Rodolfo-Pellizzoni-Lab/he-soc/hardware/ip_list/spu/README.md

# SPU — AXI4 / ACE Event Snooper

The **SPU** is a non-intrusive snooper that sits transparently on an AXI4 (or ACE) link —
between a manager and a subordinate — and forwards **event packets** describing the traffic
it observes to the **APMU**. It is how interconnect- and memory-side events (e.g. LLC and
main-memory read/write requests, and per-access latency) enter the centralized monitor. It
is one of the three IPs of the performance-monitoring architecture in our EMSOFT 2026 paper,
alongside the APMU and the per-core EVUs.

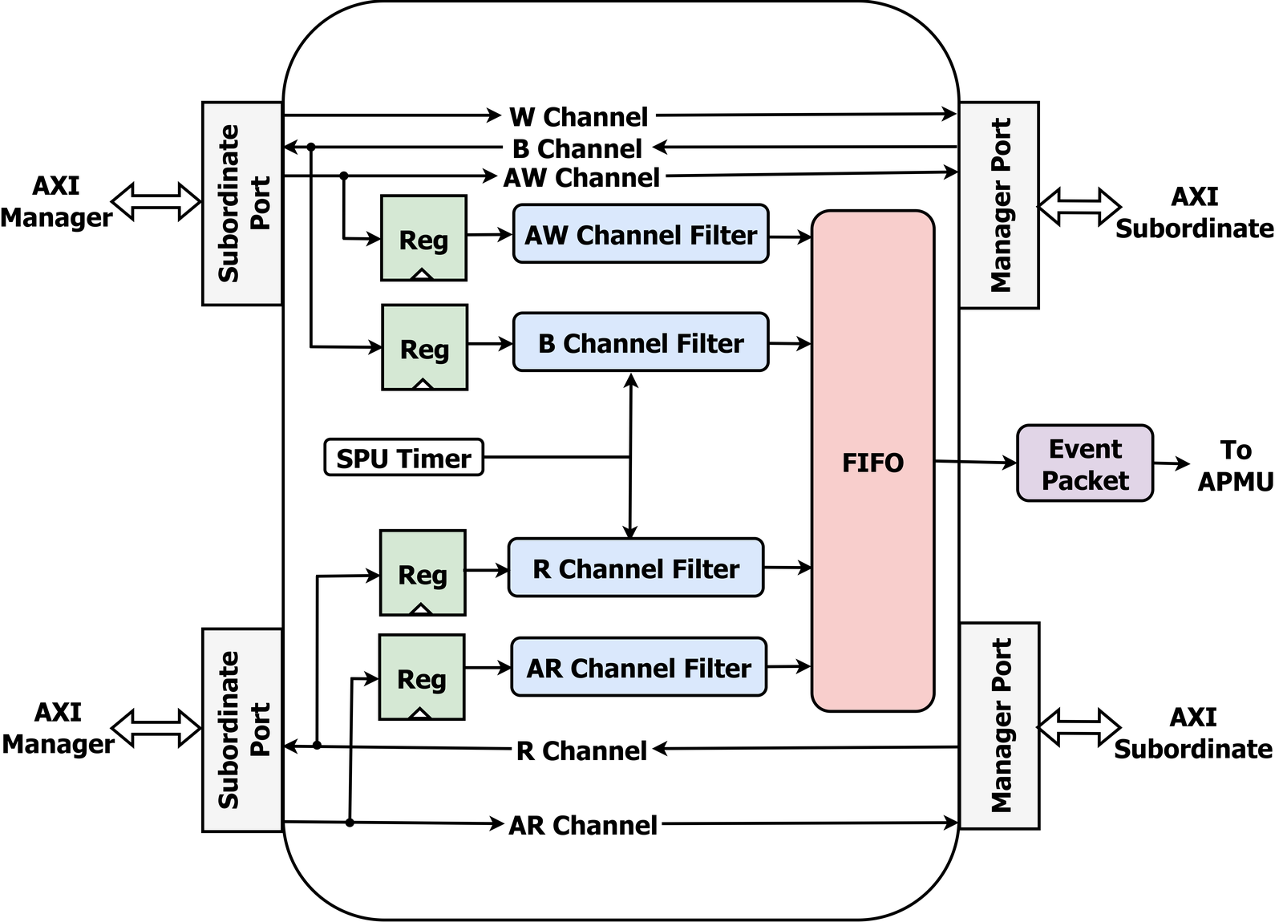
[picture p3: hardware/ip_list/spu/spu_block_diagram.png]
SPU block diagram


## How it works

- The five AXI channels pass **transparently** from the subordinate-side port (`Sb Port`,
  facing the managers) to the manager-side port (`Mn Port`, facing the subordinate) — the SPU
  never alters or delays the traffic it monitors.
- It tracks **read** transactions through the address-read (**AR**) and read-data (**R**)
  channels, and **write** transactions through the address-write (**AW**) and write-response
  (**B**) channels; the write-data (**W**) channel is not monitored. Each monitored channel is
  **sampled** (the `Reg` stage) and passed through a filter that decides which transactions
  produce events and extracts their fields (an event ID plus metadata such as transaction
  size, alignment, or response latency).
- An **SPU timer** timestamps requests and responses, so latency is measured as the time
  between a request and its corresponding response completion.
- Each event type is handled by a dedicated pipeline, and the resulting **event packets are
  stored in a FIFO** that forms the SPU's output interface to the APMU.
- Every event carries a **source**, which the APMU's per-counter source filter matches. By
  default it is a slice of the request's AXI ID (`SourceIDStart`..`SourceIDEnd`). In
  `axi_spu_top`, `ExtSource = 1` makes it the `ar_src_i` / `aw_src_i` input instead, sampled
  with the request, so the instance can derive it from the ID, the user field or both. In both
  variants a response event (R, B) reports the source of the request it answers, kept per
  outstanding request next to its start time. AlSaqr's SPUs on the LLC memory port and on
  the accelerator socket's DMA use `ExtSource` (see "In AlSaqr"); the APMU README lists the
  source codes. The memory-port SPU sits between the LLC and the slowdown regulator, so its
  response latencies include the slowdown's and the DRAM timing model's delays
  (`hardware/host/host_domain.sv`).
- A write response is counted once, also when it is held valid for several cycles (both
  variants; before 2026-10-25 a stalled B counted once per cycle).

## Variants

- `axi_spu_top.sv` — AXI4 snooper.
- `ace_spu_top.sv` — ACE snooper. **On this branch the master/slave ports are wired as
  `ACE_BUS`** (rather than `AXI_BUS`) so the SPU can observe coherent traffic.

## Source layout (`src/`)

| File | Role |
|---|---|
| `axi_spu_top.sv`, `ace_spu_top.sv` | Top-level snooper (AXI4 / ACE). |
| `spu_ax_chan.sv` | Address-channel (AR / AW) event extraction. |
| `spu_r_chan.sv` | Read-transaction tracking: matches an AR request to its R response (read latency). |
| `spu_w_chan.sv` | Write-transaction tracking: matches an AW request to its B response (write latency). |
| `spu_arbiter.sv` | Round-robin merge of the per-pipeline events into the output FIFO. |
| `spu_pkg.sv` | Package: types and parameters. |

Depends on the PULP `axi`, `ace`, and `apmu` packages (see [`Bender.yml`](./Bender.yml));
reusable AXI `typedef`/`assign` macros are in [`include/axi/`](./include/axi).

## In AlSaqr

With *N* cores (APMU ports in brackets for four cores, then for eight; the port map is `ariane_soc::Apmu*Idx`, the
APMU README has the event selects):

| Instance | Where | APMU port | Source | `CAM_DEPTH` |
|---|---|---|---|---|
| `i_spu_core_llc` (`ace_spu_top`), one per core | `hardware/host/cva6_synth_wrap.sv`, between core *c* and its port of the coherence unit | *N*+1+*c* (5-8; 9-16) | bit 0 of the core's AXI ID: it does not tell masters apart, the port is the core | 17 |
| `i_spu_llc_mem` (`axi_spu_top`) | `hardware/host/host_domain.sv`, between the LLC's memory port and the slowdown regulator | 2*N*+1 (9; 17) | `ExtSource`: `ariane_axi_soc::mem_src`, the master the request came from | 17 |
| `i_spu_accel` (`axi_spu_top`) | `hardware/host/cva6_subsystem.sv`, on the accelerator socket's DMA master in front of its port of the coherence unit | 2*N*+2 (10; 18) | `ExtSource`: the constant `ariane_soc::CcuAccelPort` (*N*: 4; 8), the code `i_spu_llc_mem` gives the socket's requests | 8 |

All of them count DRAM addresses only (rule 1 of the same 2-rule map, `[HYAXIBase, HYAXIBase + HYAXILength)`) and run
on the SoC clock. The cores' SPUs reach the APMU through a 4-entry CDC FIFO each, the other two directly. The socket's
SPU sees the accelerators' DMA before the coherence unit and the LLC (hits and misses alike) and nothing else, not the
Ethernet DMA, which has a port of its own. Each CAM holds one entry per outstanding request of its direction, inserted
whatever the address, so `CAM_DEPTH` must be at least the master's reads (writes) in flight: a request that finds the
CAM full still counts, but a response of its ID then goes uncounted. The socket has at most 4 requests in flight, reads
and writes together, all with ID 0.

An SPU's source (`SourceIDEnd - SourceIDStart + 1` bits) is zero-extended into the APMU's source field,
`pmu_pkg::SOURCE_ID_BITS` bits, which follows the core count like the APMU's port field: 4 bits with up to four cores,
5 with more (the `NUM_CVA6` define; the APMU README has both Event Sel layouts). The cores' SPUs have a 1-bit source,
the other two `ariane_soc::MemSrcWidth` bits, which is `SOURCE_ID_BITS`; `axi_spu_top` reports a wider source in
simulation.

## Simulation

```
bender update
cd scripts
./compile_vsim.sh
./run_vsim.sh
python3 post_sim_script.py <TbMasters> <TbNumReads> <TbNumWrites>
```

Testbench sources are in [`test/`](./test) (`tb_spu.sv`, `spu_test.sv`). The instances in
the full SoC are listed in "In AlSaqr" above.

`tb_spu.sv` is stale: it instantiates `spu_top`, which `src/` does not have (the tops are `axi_spu_top` and
`ace_spu_top`), so it does not elaborate. `hardware/xsim/tests/run_spu_b.sh` (testbench `tb_spu_b.sv` next to it,
no SoC build needed) is a directed xsim test of the 2026-10-25 held-B fix in `axi_spu_top`: one write-response event
per write, with its own latency and source, also while a second write of the same ID is outstanding.
`SPU_TOP_SV=<file>` runs it on another `axi_spu_top.sv`; one with the old `new_b_resp_q <= new_b_resp_q;` put back
must fail.

`software/soc_tests/t_spulat` checks the latencies in the SoC: core 0's line reads and write-backs outside the LLC
window on the memory port's SPU (APMU port 2*N*+1), each counted exactly, with their latency sums and the smallest and
largest latency (Event Info `ADD_RESP_LAT` and its `KEEP_MIN` / `KEEP_MAX` opcodes), and one DMA copy of the
accelerator socket on its SPU (port 2*N*+2) against port 2*N*+1's source *N*. In xsim, with 4 and with 8 cores: reads
38 cycles on average (31-46), write-backs 42 (36-49); the socket's reads and writes take 32 cycles more at port
2*N*+2 than at port 2*N*+1 (66 against 34, 69 against 37).

## License

Released under the **Solderpad Hardware License v0.51** (treatable, at the licensee's
option, as Apache-2.0). See [`LICENSE`](./LICENSE).
