Rodolfo-Pellizzoni-Lab/he-soc/hardware/ip_list/can_bus/doc/pics/Untitled 1.bmp

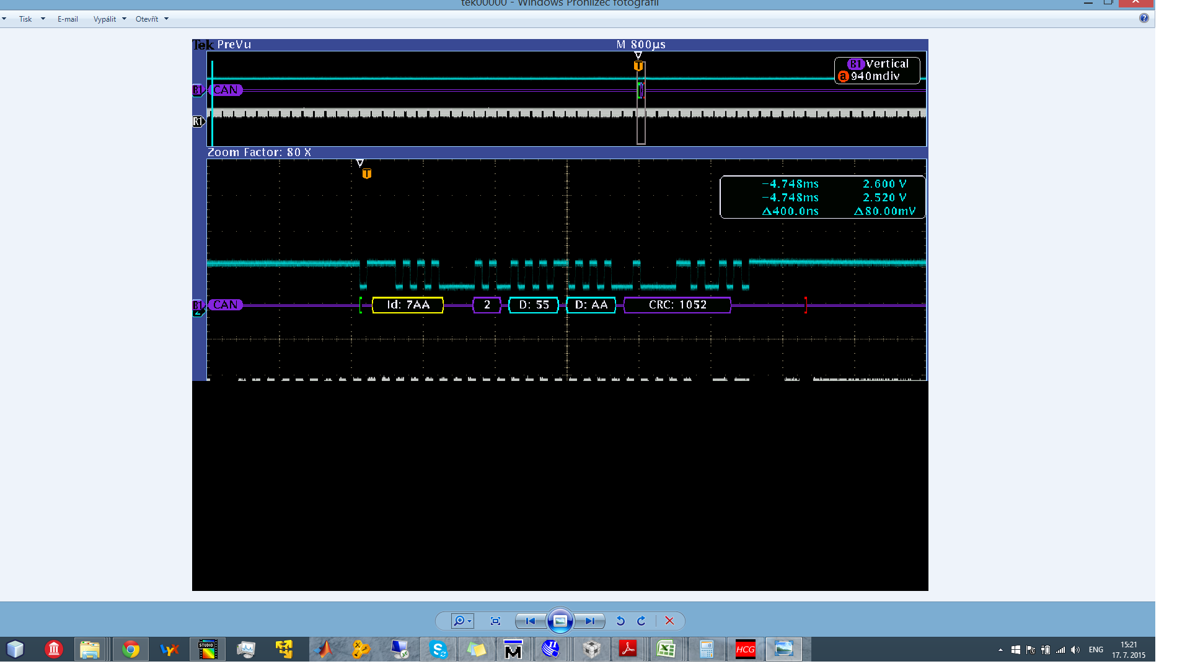
hardware/ip_list/can_bus/doc/pics/Untitled 1.bmp
