Rodolfo-Pellizzoni-Lab/he-soc/hardware/ip_list/udma_i2c/docs/I2C_reference.xlsx

Sheet: Info
Document Information
Name | I2C reference
Category | IP reference
Author | Florent Rotenberg
Version | 1.0
Status | Fisrt Release
Description | I2C interface definition
IP Information
IP type | I2C
Delivery Type
History
Date | Modification | Author
26/10/2016 | 1strelease | F.Rotenberg
Content
Info | This sheet. General information about document usage
Usage | Guidelines on how to used the various sheet
IP Release | Release information sheet describing
IPIF_relx.x | IP interface description reference, describing IP symbol/entity and integration and test information relative to IP interface.
IPDESCR_Relx.x | Description of the main features of the IP
IPREGLIST_rely.y | Description of the list of registers used by IP. Registers can be physically instanciated inside IP or outside IP.
IPREGMAP_relz.z | Description of mapping of bit fields when registers are internal to IP. This sheet is optional for IP which are not instanciating registers as information can be build from IPIF and IPRELIST sheet.
IPTREGMAP_relz.z | Description of mapping of test bit field when registers are internal to IP. This sheet is optional for IP which are not instanciating registers as information can be build from IPIF and IPRELIST sheet.
IPUDMACMDLIST_relz.z | Description of IP UDMA commands list used by IP.

Sheet: Usage
IP Release Sheet
 | Column | Description | Possible Value
 | Version | IP release version numeroted as [major release].[minor release]. A release is major whenever IP interface is modified. | X.Y. Z
 | Release description | This is a free text entry expliciting the release main modifications and purpose. | Text
 | IPIF | IPIF sheet version to be used for this release. | X.Y. Z
 | IPDESCR | IPDESCR sheet version to nbe used for this release | X.Y.Z
 | IPREGLIST | IPREGLIST sheet version to be used for this release. | X.Y. Z
 | IPREGMAP | IPREGMAP sheet version to be used for this release. | X.Y. Z
 | IPUDMACMDLIST | IPUDMACMDLIST sheet version to be used for this release. | X.Y. Z
 | IPDOC | IPDOC version to be used for this release. | X.Y. Z
 | GIT version | GIT database number corresponding to IP design code and IP reference XLS. | Integer
IPIF sheet
IP Interface description | IP Pin Name | Name of IP Pin. This must must exactly name find in code or schematic (including case).
 | Direction | Direction or type of signal | In,Out,IO
 | Type | Analog, Digital, supply, DR (Dual Rail), SR (SingleRail) | Analog,Digital, VDD, GND, DR, SR
 | Voltage Domain
 | Clock domain
 | IO
 | Size
 | Reset Value
 | Description
Integration information | Integration comment
 | Core Interface
 | Register Interface
 | Register name
 | DFT value
 | Level Shifter
 | Isolation cell
 | Connected to
 | Load
 | Drive
 | Destination supply
Hard Macro information | location
 | layer
 | Antenna
Additonal Information | FreeText 1
 | FreeText 2
Driver information | Function1
 | Function2

Sheet: IP Release
Version | Release description | IPIF | IPDESCR | IPREGLIST | IPREGMAP | IPUDMACMDLIST | IPDOC | GIT version
1.0.0 |  | Rel1.0.0 | Rel1.0.0 | Rel1.0.0 | Rel1.0.0 | Rel1.0.0

Sheet: IPIF_rel1.0.0
IP Interface description |  |  |  |  |  |  |  |  | Integration information |  |  |  |  |  |  |  |  |  |  |  |  | Hard Macro information |  |  | Additonal Information |  | Driver information
IP Pin Name | Direction | Type | Voltage Domain | Clock domain | IO | Size | Reset Value | Description | Integration comment | Core Interface | Register Interface | Register name | Bit position | Trim during production | DFT value | Level Shifter | Isolation cell | Connected to | Load | Drive | Destination supply | location | layer | Antenna | FreeText 1 | FreeText 2 | Function1 | Function2
clk_i | IN | digital
rstn_i | IN | digital
ext_events_i | IN | digital
cfg_data_i | IN | digital
cfg_addr_i | IN | digital
cfg_valid_i | IN | digital
cfg_rwn_i | IN | digital
cfg_data_o | OUT | digital
cfg_ready_o | OUT | digital
cfg_rx_startaddr_o | OUT | digital
cfg_rx_size_o | OUT | digital
cfg_rx_continuous_o | OUT | digital
cfg_rx_en_o | OUT | digital
cfg_rx_clr_o | OUT | digital
cfg_rx_en_i | IN | digital
cfg_rx_pending_i | IN | digital
cfg_rx_curr_addr_i | IN | digital
cfg_rx_bytes_left_i | IN | digital
cfg_tx_startaddr_o | OUT | digital
cfg_tx_size_o | OUT | digital
cfg_tx_continuous_o | OUT | digital
cfg_tx_en_o | OUT | digital
cfg_tx_clr_o | OUT | digital
cfg_tx_en_i | IN | digital
cfg_tx_pending_i | IN | digital
cfg_tx_curr_addr_i | IN | digital
cfg_tx_bytes_left_i | IN | digital
data_rx_datasize_o | OUT | digital
data_rx_data_o | OUT | digital
data_rx_valid_o | OUT | digital
data_rx_ready_i | IN | digital
data_tx_datasize_o | OUT | digital
data_tx_data_i | IN | digital
data_tx_valid_i | IN | digital
data_tx_ready_o | OUT | digital
err_o | OUT | digital
scl_i | IN | digital
scl_o | OUT | digital
scl_oe | OUT | digital
sda_i | IN | digital
sda_o | OUT | digital
sda_oe | OUT | digital

Sheet: IPDESCR_rel1.0.0
Description
I2C component manages the following features: - Controls all I2C bus specific sequencing, protocol, arbitration and timing. - Configurable I2C clock frequency related to SoC clock frequency. - Status flags for busy bus and arbitration lost.
I2C interface uses a [stream pre-processing protocol](#i2cstreampre-processingprotocol) to ease the construction of I2C transfers combining commands and data stream. A list of the available commands and their encoding is shown in the [table below](#udma_i2c_commands).

Sheet: IPREGLIST_rel1.0.0
Register Name | Address | Size | Register Type | Host Access Type | IP access Type | Default Value | Description | FootNote | Comment
RX_SADDR | 0x0 | 32 | Config | R/W | R/W | 0x0 | uDMA RX I2C buffer base address configuration register.
RX_SIZE | 0x4 | 32 | Config | R/W | R/W | 0x0 | uDMA RX I2C buffer size configuration register.
RX_CFG | 0x8 | 32 | Config | R/W | R/W | 0x0 | uDMA RX I2C stream configuration register.
TX_SADDR | 0x10 | 32 | Config | R/W | R/W | 0x0 | uDMA TX I2C buffer base address configuration register.
TX_SIZE | 0x14 | 32 | Config | R/W | R/W | 0x0 | uDMA TX I2C buffer size configuration register.
TX_CFG | 0x18 | 32 | Config | R/W | R/W | 0x0 | uDMA TX I2C stream configuration register.
CMD_SADDR | 0x20 | 32 | Config | R/W | R/W | 0x0 | uDMA CMD I2C buffer base address configuration register.
CMD_SIZE | 0x24 | 32 | Config | R/W | R/W | 0x0 | uDMA CMD I2C buffer size configuration register.
CMD_CFG | 0x28 | 32 | Config | R/W | R/W | 0x0 | uDMA CMD I2C stream configuration register.
STATUS | 0x30 | 32 | Status | R/W | W | 0x0 | uDMA I2C Status register.
SETUP | 0x34 | 32 | Config | R/W | R | 0x0 | uDMA I2C Configuration register.

Sheet: IPREGMAP_rel1.0.0
Bit field | Register | Bit Position | Size | Host Access Type | IP access Type | Reset Value | Description
RX_SADDR | RX_SADDR | 0 | 21 | R/W | R/W | 0x0 | RX buffer base address bitfield: - Read: returns value of the buffer pointer until transfer is finished. Else returns 0. - Write: sets RX buffer base address
RX_SIZE | RX_SIZE | 0 | 20 | R/W | R/W | 0x0 | RX buffer size bitfield in bytes. (128kBytes maximum) - Read: returns remaining buffer size to transfer. - Write: sets buffer size.
CONTINOUS | RX_CFG | 0 | 1 | R/W | R/W | 0x0 | RX channel continuous mode bitfield: -1'b0: disabled -1'b1: enabled At the end of the buffer transfer, the uDMA reloads the address / buffer size and starts a new transfer.
EN | RX_CFG | 4 | 1 | R/W | R/W | 0x0 | RX channel enable and start transfer bitfield: -1'b0: disable -1'b1: enable and start the transfer This signal is used also to queue a transfer if one is already ongoing.
PENDING | RX_CFG | 5 | 1 | R | W | 0x0 | RX transfer pending in queue status flag: -1'b0: no pending transfer in the queue -1'b1: pending transfer in the queue
CLR | RX_CFG | 6 | 1 | W | R | 0x0 | RX channel clear and stop transfer: -1'b0: disable -1'b1: stop and clear the on-going transfer
TX_SADDR | TX_SADDR | 0 | 21 | R/W | R/W | 0x0 | TX buffer base address bitfield: - Read: returns value of the buffer pointer until transfer is finished. Else returns 0. - Write: sets buffer base address
TX_SIZE | TX_SIZE | 0 | 20 | R/W | R/W | 0x0 | TX buffer size bitfield in bytes. (128kBytes maximum) - Read: returns remaining buffer size to transfer. - Write: sets buffer size.
CONTINOUS | TX_CFG | 0 | 1 | R/W | R/W | 0x0 | TX channel continuous mode bitfield: -1'b0: disabled -1'b1: enabled At the end of the buffer transfer, the uDMA reloads the address / buffer size and starts a new transfer.
EN | TX_CFG | 4 | 1 | R/W | R/W | 0x0 | TX channel enable and start transfer bitfield: -1'b0: disabled -1'b1: enable and start the transfer This signal is used also to queue a transfer if one is already ongoing.
PENDING | TX_CFG | 5 | 1 | R | W | 0x0 | TX transfer pending in queue status flag: -1'b0: no pending transfer in the queue -1'b1: pending transfer in the queue
CLR | TX_CFG | 6 | 1 | W | R | 0x0 | TX channel clear and stop transfer bitfield: -1'b0: disabled -1'b1: stop and clear the on-going transfer
CMD_SADDR | CMD_SADDR | 0 | 21 | R/W | R/W | 0x0 | CMD buffer base address bitfield: - Read: returns value of the buffer pointer until transfer is finished. Else returns 0. - Write: sets buffer base address
CMD_SIZE | CMD_SIZE | 0 | 20 | R/W | R/W | 0x0 | CMD buffer size bitfield in bytes. (128kBytes maximum) - Read: returns remaining buffer size to transfer. - Write: sets buffer size.
CONTINOUS | CMD_CFG | 0 | 1 | R/W | R/W | 0x0 | CMD channel continuous mode bitfield: -1'b0: disabled -1'b1: enabled At the end of the buffer transfer, the uDMA reloads the address / buffer size and starts a new transfer.
EN | CMD_CFG | 4 | 1 | R/W | R/W | 0x0 | CMD channel enable and start transfer bitfield: -1'b0: disabled -1'b1: enable and start the transfer This signal is used also to queue a transfer if one is already ongoing.
PENDING | CMD_CFG | 5 | 1 | R | W | 0x0 | CMD transfer pending in queue status flag: -1'b0: no pending transfer in the queue -1'b1: pending transfer in the queue
CLR | CMD_CFG | 6 | 1 | W | R | 0x0 | CMD channel clear and stop transfer bitfield: -1'b0: disabled -1'b1: stop and clear the on-going transfer
BUSY | STATUS | 0 | 1 | R/W | W | 0x0 | I2C bus busy status flag: - 1'b0: no transfer on-going - 1'b1: transfer on-going
ARB_LOST | STATUS | 1 | 1 | R/W | W | 0x0 | I2C arbitration lost status flag: - 1'b0: no error - 1'b1: arbitration lost error
ACK | STATUS | 2 | 1 | R | W | 0x0 | I2C ack flag, can be polling for busy: - 1'b0: ACK - 1'b1: NAK
DO_RST | SETUP | 0 | 1 | R/W | R | 0x0 | Reset command used to abort the on-going transfer and clear busy and arbitration lost status flags.

Sheet: IPUDMACMDLIST_rel1.0.0
Command name | Size | Command field | Parameter | Parameter Size | Description
I2C_CMD_START | 32 | 0x0 |  |  | I2C Start of Transfer command.
I2C_CMD_STOP | 32 | 0x2 |  |  | I2C End of Transfer command.
I2C_CMD_RD_ACK | 32 | 0x4 |  |  | I2C receive data and acknowledge command.
I2C_CMD_RD_NACK | 32 | 0x6 |  |  | I2C receive data and not acknowledge command.
I2C_CMD_WR | 32 | 0x8 | The value following the I2C_CMD_WR command indicates byte value to transmit or multiple byte values to transmit if this command is preceded by a I2C_CMD_RPT command. | 1 byte or many bytes if preceded by a I2C_CMD_RPT command. | I2C send data and wait acknowledge command.
I2C_CMD_WAIT | 32 | 0xA | The value following the I2C_CMD_WAIT command indicates I2C dummy clock cycles value. | 2 bytes(bit[15:0]) | I2C wait dummy cycles command.
I2C_CMD_RPT | 32 | 0xC | The value following the I2C_CMD_RPT command indicates number of times to repeat next command. | 1 byte. | I2C next command repeat command.
I2C_CMD_CFG | 32 | 0xE | The value following the I2C_CMD_CFG command indicates I2C clock divider 16bits value related to SoC clock frequency. | 2 bytes. | I2C configuration command.
I2C_CMD_WAIT_EV | 32 | 0x1 | The value following the I2C_CMD_WAIT_EV command indicates selected uDMA external event ID. | 1 byte (bit[1:0] – event_id). | I2C wait uDMA external event command.
I2C_CMD_WRB | 32 | 0x7 | The value in the lowest byte will be sent on the bus | 1 byte | I2C write byte command
I2C_CMD_EOT | 32 | 0x9 |  |  | Signal end of transfer (next transfer may be en-queued)
I2C_CMD_SETUP_UCA | 32 | 0x3 | Bit 27 describe if read or write / bits[23:0] are the buffer(tx or rx) address | 1(bit[27]) + 24(bit[23:0]) | Setup RX or TX channel start address
I2C_CMD_SETUP_UCS | 32 | 0x5 | Bit 27 describe if read or write / bits[15:0] are the buffer(tx or rx) size | 1(bit27) + 15(bit[15:0] | Setup RX or TX channel transfer size+enable channel

Sheet: IPUDMACMDMAP_rel1.0.0
Parameter bit field | Command name | Bit position | Size | Field value | Description
I2C_CMD | I2C_CMD_START | 28 | 4 | 0x0 | I2C Start of Transfer command.
I2C_CMD | I2C_CMD_STOP | 28 | 4 | 0x2 | I2C End of Transfer command.
I2C_CMD | I2C_CMD_RD_ACK | 28 | 4 | 0x4 | I2C receive data and acknowledge command.
I2C_CMD | I2C_CMD_RD_NACK | 28 | 4 | 0x6 | I2C receive data and not acknowledge command.
I2C_CMD | I2C_CMD_WR | 28 | 4 | 0x8 | I2C send data and wait acknowledge command.
I2C_CMD | I2C_CMD_WAIT | 28 | 4 | 0xA | I2C wait dummy cycles command.
DUMMY_CYCLES | I2C_CMD_WAIT | 0 | 16 | ARG | dummy cycles to wait
I2C_CMD | I2C_CMD_RPT | 28 | 4 | 0xC | I2C next command repeat command.
RPT_NB | I2C_CMD_RPT | 0 | 16 | ARG | number of repeats to do
I2C_CMD | I2C_CMD_CFG | 28 | 4 | 0xE | I2C configuration command.
CFG | I2C_CMD_CFG | 0 | 16 | ARG | I2C configuration
I2C_CMD | I2C_CMD_WAIT_EV | 28 | 4 | 0x1 | I2C wait uDMA external event command.
I2C_CMD | I2C_CMD_WRB | 28 | 4 | 0x7 | I2C write byte command
DATA_BYTE | I2C_CMD_WRB | 0 | 8 | ARG | byte to be written
I2C_CMD | I2C_CMD_EOT | 28 | 4 | 0x9 | I2C End of Transfer command.
I2C_CMD | I2C_CMD_SETUP_UCA | 28 | 4 | 0x3 | I2C rx/tx channel address configuration command
TXRXN | I2C_CMD_SETUP_UCA | 27 | 1 | ARG | tx/rx selection (tx if 1, rx if 0)
SADDR | I2C_CMD_SETUP_UCA | 0 | 24 | ARG | rx/tx channel start address
I2C_CMD | I2C_CMD_SETUP_UCS | 28 | 4 | 0x5 | I2C rx/tx channel transfer size configuration command
TXRXN | I2C_CMD_SETUP_UCS | 27 | 1 | ARG | tx/rx selection (tx if 1, rx if 0)
SIZE | I2C_CMD_SETUP_UCS | 0 | 16 | ARG | rx/tx channel transfer size

Sheet: VerPlan_rel1.0.0
Name | Description | testcase location&name | Status
Reg test | test default value and rw access to all registers
Read byte | read a byte from device (eprom)
write byte | write a byte to device (eprom)
Read chain | read a chain of bytes from device (eprom)
write chain | write a chain of bytes to device (eprom)
wait events | wait on event propagated by uDMA
