Rodolfo-Pellizzoni-Lab/he-soc/hardware/ip_list/hyperbus_udma/.old/umcl65/encounter/src/hyperbus_chip_img_ord.pdf

1

2

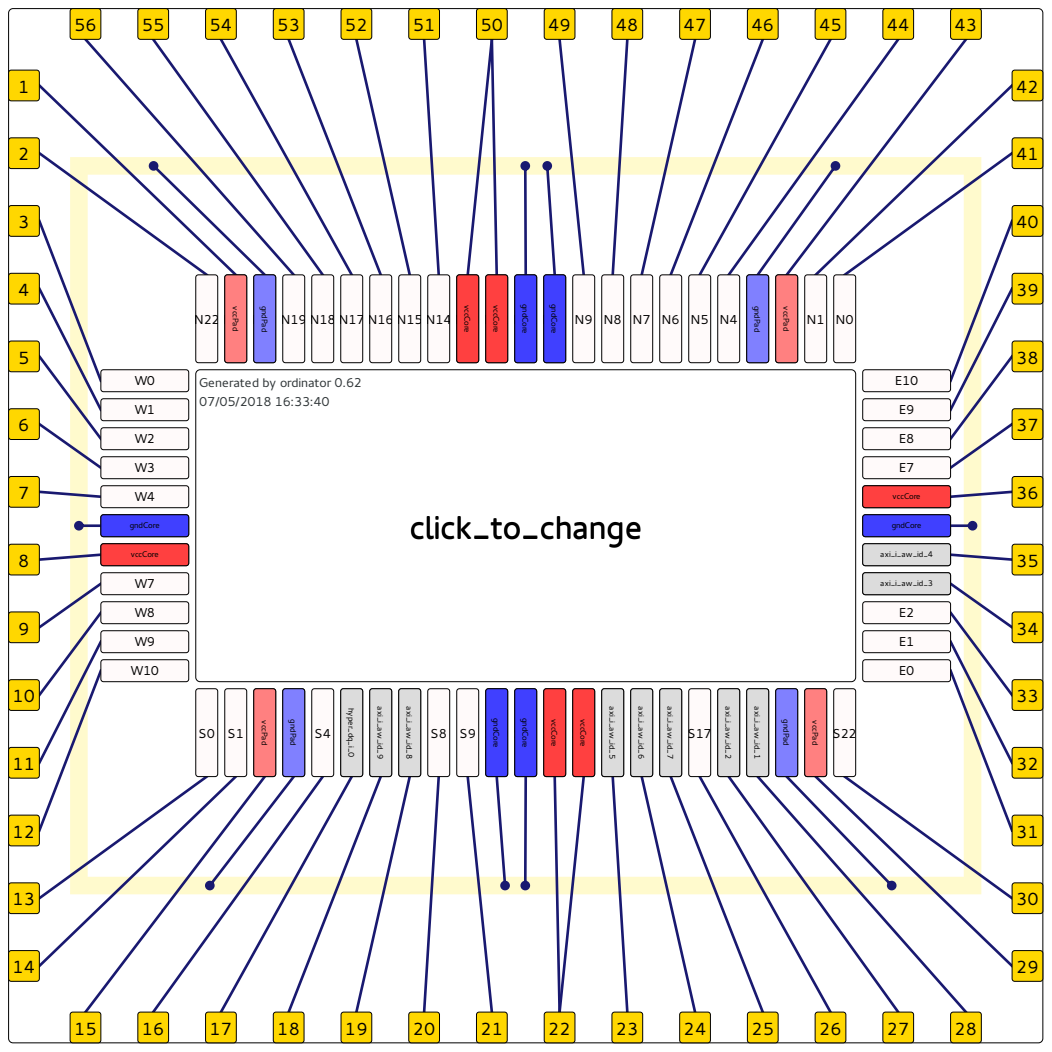
[picture p7: page 1]
click_to_change; gndCore; vccCore; vccPad; gndPad; hyper_dq_i_0; axi_i_aw_id_9; axi_i_aw_id_8; axi_i_aw_id_7; axi_i_aw_id_6; axi_i_aw_id_5; axi_i_aw_id_4; axi_i_aw_id_3; axi_i_aw_id_2; axi_i_aw_id_1

Generated by ordinator 0.62
