Rodolfo-Pellizzoni-Lab/he-soc/hardware/host/host_domain.sv

// Copyright 2018 ETH Zurich and University of Bologna.
// Copyright and related rights are licensed under the Solderpad Hardware
// License, Version 0.51 (the "License"); you may not use this file except in
// compliance with the License.  You may obtain a copy of the License at
// http://solderpad.org/licenses/SHL-0.51. Unless required by applicable law
// or agreed to in writing, software, hardware and materials distributed under
// this License is distributed on an "AS IS" BASIS, WITHOUT WARRANTIES OR
// CONDITIONS OF ANY KIND, either express or implied. See the License for the
// specific language governing permissions and limitations under the License.
//
// Author: Florian Zaruba, ETH Zurich
// Date: 19.03.2017
// Description: Test-harness for Ariane
//              Instantiates an AXI-Bus and memories

`include "register_interface/typedef.svh"
`include "register_interface/assign.svh"
`include "axi/assign.svh"
`include "axi/typedef.svh"
`include "common_cells/registers.svh"
`define APMU_IOPMP
`define APMU_IP
// ---- Slowdown regulator enable switch (ip_list/slowdown) ----
//   `define USE_SLOWDOWN  => LLC -> SPU -> slowdown -> DRAM timing model -> memory (normal operation)
//     (left commented)    => LLC -> SPU -> DRAM timing model -> memory           (slowdown bypassed)
`define USE_SLOWDOWN

module host_domain
  import axi_pkg::xbar_cfg_t;
  import ariane_soc::HyperbusNumPhys;
  import ariane_soc::NumChipsPerHyperbus;
  import apb_soc_pkg::NUM_ADV_TIMER;
  import ariane_soc::*;
  import udma_subsystem_pkg::*;
  import gpio_pkg::*;
  `ifndef FPGA_EMUL
    `ifndef SIMPLE_PADFRAME
        import pkg_alsaqr_periph_padframe::*;
      `else
        import pkg_alsaqr_periph_fpga_padframe::*;
      `endif
  `else
      import pkg_alsaqr_periph_fpga_padframe::*;
  `endif
  import axi_llc_pkg::events_t;
#(
  parameter int unsigned AXI_USER_WIDTH    = 1,
  parameter int unsigned AXI_ADDRESS_WIDTH = 64,
  parameter int unsigned AXI_DATA_WIDTH    = 64,
  // AXILITE parameters
  parameter int unsigned AXI_LITE_AW       = 32,
  parameter int unsigned AXI_LITE_DW       = 32,
`ifdef DROMAJO
  parameter bit          InclSimDTM        = 1'b0,
`else
  parameter bit          InclSimDTM        = 1'b1,
`endif
  parameter int unsigned NUM_WORDS         = 2**25,         // memory size
  parameter bit          StallRandomOutput = 1'b0,
  parameter bit          StallRandomInput  = 1'b0,
  parameter bit          JtagEnable        = 1'b1,
  parameter int unsigned CAM_DATA_WIDTH    = 8,
  parameter int unsigned NUM_GPIO          = 64,
  parameter type         axi_req_t         = logic,
  parameter type         axi_rsp_t         = logic
) (
  input logic                 rtc_i,
  input logic                 rst_ni,
  input logic                 bypass_clk_i,
  output logic                soc_clk_o,
  output logic                soc_rst_no,
  output logic                clk_cluster_o,
  output logic                clk_opentitan_o,
  output logic                rstn_cluster_sync_o,
  output logic                cluster_en_sa_boot_o,
  output logic                cluster_fetch_en_o,
  output logic                dma_pe_evt_ack_o,
  input  logic                dma_pe_evt_valid_i,
  input  logic                cluster_eoc_i,
  output logic                h2c_irq_o,
  REG_BUS.out                 padframecfg_reg_master,
  // CVA6 DEBUG UART
  input logic                 cva6_uart_rx_i,
  output logic                cva6_uart_tx_o,

  // JTAG
  input logic                 jtag_TCK,
  input logic                 jtag_TMS,
  input logic                 jtag_TDI,
  input logic                 jtag_TRSTn,
  output logic                jtag_TDO_data,
  output logic                jtag_TDO_driven,

  `ifdef XILINX_DDR
  AXI_BUS.Master              axi_ddr_master,
  `endif
  // SoC to cluster AXI
  AXI_BUS.Master              cluster_axi_master,
  AXI_BUS.Slave               cluster_axi_slave,
  AXI_BUS.Slave               cluster_lite_slave,
  // TLB Config
  AXI_LITE.Master             c2h_tlb_cfg_lite_master,
  // SPIM
  output                      qspi_to_pad_t [N_SPI-1:0] spi_to_pad,
  input                       pad_to_qspi_t [N_SPI-1:0] pad_to_spi,

  // QSPIM
  output                      qspi_to_pad_t [N_QSPI-1:0] qspi_to_pad,
  input                       pad_to_qspi_t [N_QSPI-1:0] pad_to_qspi,

  // I2C
  output                      i2c_to_pad_t [N_I2C-1:0] i2c_to_pad,
  input                       pad_to_i2c_t [N_I2C-1:0] pad_to_i2c,

  // CAM
  input                       pad_to_cam_t [N_CAM-1:0] pad_to_cam,

  // UART
  input                       pad_to_uart_t [N_UART-1:0] pad_to_uart,
  output                      uart_to_pad_t [N_UART-1:0] uart_to_pad,

  // USART
  input                       pad_to_usart_t [N_USART-1:0] pad_to_usart,
  output                      usart_to_pad_t [N_USART-1:0] usart_to_pad,

  // SDIO
  output                      sdio_to_pad_t [N_SDIO-1:0] sdio_to_pad,
  input                       pad_to_sdio_t [N_SDIO-1:0] pad_to_sdio,

  //CAN
  output                      can_to_pad_t [N_CAN-1 : 0] can_to_pad,
  input                       pad_to_can_t [N_CAN-1 : 0] pad_to_can,

  //ETHERNET
  output                      eth_to_pad_t eth_to_pad,
  input                       pad_to_eth_t pad_to_eth,
  output                      xeth_to_pad_t xeth_to_pad,   // Xilinx AXI Ethernet (XILINX_ETHERNET)
  input                       pad_to_xeth_t pad_to_xeth,

  `ifdef ETH2FMC_NO_PADFRAME
  input logic                   clk_200MHz,
  input logic                   clk_125MHz,
  input logic                   clk_125MHz90,
  `endif

  // HYPERBUS
  `ifndef XILINX_DDR
  inout  [HyperbusNumPhys-1:0][NumChipsPerHyperbus-1:0] pad_hyper_csn,
  inout  [HyperbusNumPhys-1:0]                          pad_hyper_ck,
  inout  [HyperbusNumPhys-1:0]                          pad_hyper_ckn,
  inout  [HyperbusNumPhys-1:0]                          pad_hyper_rwds,
  inout  [HyperbusNumPhys-1:0]                          pad_hyper_reset,
  inout  [HyperbusNumPhys-1:0][7:0]                     pad_hyper_dq,
  `endif

  output                      pwm_to_pad_t pwm_to_pad,

  // FLL output
  output                      fll_to_pad_t    fll_to_pad,

  output gpio_to_pad_t        gpio_to_pad,
  input  pad_to_gpio_t        pad_to_gpio,

  // OpenTitan axi master
  input  axi_req_t            ot_axi_req,
  output axi_rsp_t            ot_axi_rsp,

  // SCMI mailbox interrupt to Ibex
  output  logic               doorbell_irq_o,
  output  logic               cfi_req_irq_o,
  output  logic               snoop_watermark_irq_o,
    // Logic locking registers
  output logic [127:0]        cluster_lock_xor_key_o
);


   ariane_axi_soc::req_slv_t  axi_cpu_req;
   ariane_axi_soc::resp_slv_t axi_cpu_res;

   ariane_axi_soc::req_slv_mem_t  axi_mem_req;
   ariane_axi_soc::resp_slv_mem_t axi_mem_res;
   // the DRAM timing model (host/axi_dram_timing.sv): its input after the slowdown, its output to the DRAM path
   ariane_axi_soc::req_slv_mem_t  axi_model_req;
   ariane_axi_soc::resp_slv_mem_t axi_model_res;
   ariane_axi_soc::req_slv_mem_t  axi_dram_req;
   ariane_axi_soc::resp_slv_mem_t axi_dram_res;
   dram_model_pkg::cfg_t          s_dram_model_cfg;
   dram_model_pkg::cnt_t          s_dram_model_cnt;

   ariane_axi_soc::req_lite_t  axi_llc_cfg_req;
   ariane_axi_soc::resp_lite_t axi_llc_cfg_res;

   ariane_axi_soc::req_lite_t  axi_lite_snooper_req;
   ariane_axi_soc::resp_lite_t axi_lite_snooper_rsp;

   // rule definitions
   typedef struct packed {
     int unsigned             idx;
     ariane_axi_soc::addr_t   start_addr;
     ariane_axi_soc::addr_t   end_addr;
   } rule_full_t;

   // When changing these parameters, change the L2 size accordingly in ariane_soc_pkg
   localparam NB_L2_BANKS = 8;
   localparam L2_BANK_SIZE = 1024; // 2^10 words (32 bits)

   localparam L2_BANK_ADDR_WIDTH = $clog2(L2_BANK_SIZE);
   localparam L2_MEM_ADDR_WIDTH = $clog2(L2_BANK_SIZE * NB_L2_BANKS) - $clog2(NB_L2_BANKS);
   localparam L2_DATA_WIDTH = 32 ; // Do not change

   localparam AXI64_2_TCDM32_N_PORTS = 4; // Do not change, to achieve full bandwith from 64 bit AXI and 32 bit tcdm we need 4 ports!
                                          // It is hardcoded in the axi2tcdm_wrap module.

   localparam NB_UDMA_TCDM_CHANNEL = 2;

   localparam AXI_LITE_DATA_WIDTH = 32;

   `ifdef APMU_IP
    localparam int unsigned APMU_NUM_COUNTER = 32;
  `else
    localparam int unsigned APMU_NUM_COUNTER = 0;
  `endif

   // parameters for the LLC
   localparam NUM_WAYS   = 32'd8;
   localparam NUM_LINES  = 32'd256;
   localparam NUM_BLOCKS = 32'd8;

   logic                                 s_clk_cva6;
   logic                                 s_rstn_cva6_sync;
   logic                                 s_soc_clk;
   logic                                 s_synch_soc_rst;
   logic                                 s_synch_global_rst;
   logic                                 s_rstn_cluster_sync;
   logic                                 s_dm_rst;
   logic                                 ndmreset_n;
   logic [31*4-1:0]                      s_udma_events;
   logic                                 s_dma_pe_evt;
   logic [N_CAN-1:0]                     s_can_irq;
   logic [NUM_ADV_TIMER-1 : 0]           s_pwm_irq;
   logic                                 s_c2h_irq;
   logic [NUM_GPIO-1:0]                  s_gpio_irq;

   logic                                 s_llc_read_hit_cache;
   logic                                 s_llc_read_miss_cache;
   logic                                 s_llc_write_hit_cache;
   logic                                 s_llc_write_miss_cache;

   logic[31:0]                           s_llc_cache_addr_start;
   logic[31:0]                           s_llc_cache_addr_end;
   logic[31:0]                           s_llc_spm_addr_start;

   logic                                 s_eth_clk_200MHz_i;
   logic                                 s_eth_clk_i;
   logic                                 s_eth_phy_tx_clk_i;

   logic                                 iopmp_irq;

   axi_llc_pkg::events_t llc_events;

   logic completion_irq_o;

   logic [127:0] iommu_lock_xor_key;
   logic [127:0] iopmp_lock_xor_key;
   logic [127:0] aia_lock_xor_key;

   assign   soc_clk_o  = s_soc_clk;
   assign   soc_rst_no = s_synch_soc_rst;
   assign   rstn_cluster_sync_o = s_rstn_cluster_sync;

  `ifdef ETH2FMC_NO_PADFRAME
     assign   s_eth_clk_200MHz_i = clk_200MHz;
     assign   s_eth_phy_tx_clk_i = clk_125MHz;
     assign   s_eth_clk_i        = clk_125MHz90;
  `else
     assign   s_eth_clk_200MHz_i = s_soc_clk ;
     clk_gen_hyper i_clk_gen_ethernet (
          .clk_i    ( s_periph_clk                ),
          .rst_ni   ( s_synch_soc_rst             ),
          .clk0_o   ( s_eth_phy_tx_clk_i          ),
          .clk90_o  ( s_eth_clk_i                 ),
          .clk180_o (                             ),
          .clk270_o (                             )
      );
  `endif

   AXI_BUS #(
     .AXI_ADDR_WIDTH ( AXI_ADDRESS_WIDTH        ),
     .AXI_DATA_WIDTH ( AXI_DATA_WIDTH           ),
     .AXI_ID_WIDTH   ( ariane_soc::IdWidthSlave ),
     .AXI_USER_WIDTH ( AXI_USER_WIDTH           )
   ) l2_axi_bus();

   AXI_BUS #(
     .AXI_ADDR_WIDTH ( AXI_ADDRESS_WIDTH        ),
     .AXI_DATA_WIDTH ( AXI_DATA_WIDTH           ),
     .AXI_ID_WIDTH   ( ariane_soc::IdWidthSlave ),
     .AXI_USER_WIDTH ( AXI_USER_WIDTH           )
   ) apb_axi_bus();

   AXI_BUS #(
     .AXI_ADDR_WIDTH ( AXI_ADDRESS_WIDTH        ),
     .AXI_DATA_WIDTH ( AXI_DATA_WIDTH           ),
     .AXI_ID_WIDTH   ( ariane_soc::IdWidthSlave ),
     .AXI_USER_WIDTH ( AXI_USER_WIDTH           )
   ) hyper_axi_bus();

   AXI_BUS #(
     .AXI_ADDR_WIDTH ( AXI_ADDRESS_WIDTH        ),
     .AXI_DATA_WIDTH ( AXI_DATA_WIDTH           ),
     .AXI_ID_WIDTH   ( ariane_soc::IdWidthSlave ),
     .AXI_USER_WIDTH ( AXI_USER_WIDTH           )
   ) host_lite_bus ();

   //uDMA -> XBAR
   AXI_BUS #(
     .AXI_ADDR_WIDTH ( AXI_ADDRESS_WIDTH        ),
     .AXI_DATA_WIDTH ( AXI_DATA_WIDTH           ),
     .AXI_ID_WIDTH   ( ariane_soc::IdWidth      ),
     .AXI_USER_WIDTH ( AXI_USER_WIDTH           )
   ) udma_rx_l3_axi_bus();

   //uDMA -> XBAR
   AXI_BUS #(
     .AXI_ADDR_WIDTH ( AXI_ADDRESS_WIDTH        ),
     .AXI_DATA_WIDTH ( AXI_DATA_WIDTH           ),
     .AXI_ID_WIDTH   ( ariane_soc::IdWidth      ),
     .AXI_USER_WIDTH ( AXI_USER_WIDTH           )
   ) udma_tx_l3_axi_bus();

   AXI_BUS #(
     .AXI_ADDR_WIDTH ( AXI_ADDRESS_WIDTH          ),
     .AXI_DATA_WIDTH ( AXI_DATA_WIDTH             ),
     `ifdef EXCLUDE_LLC
     .AXI_ID_WIDTH   ( ariane_soc::IdWidthSlave   ),
     `else
     .AXI_ID_WIDTH   ( ariane_soc::IdWidthSlave+1 ),
     `endif
     .AXI_USER_WIDTH ( AXI_USER_WIDTH             )
   ) mem_axi_bus ();

   AXI_BUS #(
    .AXI_ADDR_WIDTH ( AXI_ADDRESS_WIDTH          ),
    .AXI_DATA_WIDTH ( AXI_DATA_WIDTH             ),
    `ifdef EXCLUDE_LLC
    .AXI_ID_WIDTH   ( ariane_soc::IdWidthSlave   ),
    `else
    .AXI_ID_WIDTH   ( ariane_soc::IdWidthSlave+1 ),
    `endif
    .AXI_USER_WIDTH ( AXI_USER_WIDTH             )
   ) mem_axi_bus_spu_o_bus();

   // Intermediate AXI buses: SPU master -> slowdown regulator -> DRAM timing model
   AXI_BUS #(
    .AXI_ADDR_WIDTH ( AXI_ADDRESS_WIDTH          ),
    .AXI_DATA_WIDTH ( AXI_DATA_WIDTH             ),
    `ifdef EXCLUDE_LLC
    .AXI_ID_WIDTH   ( ariane_soc::IdWidthSlave   ),
    `else
    .AXI_ID_WIDTH   ( ariane_soc::IdWidthSlave+1 ),
    `endif
    .AXI_USER_WIDTH ( AXI_USER_WIDTH             )
   ) mem_axi_bus_spu_mst();

   AXI_BUS #(
    .AXI_ADDR_WIDTH ( AXI_ADDRESS_WIDTH          ),
    .AXI_DATA_WIDTH ( AXI_DATA_WIDTH             ),
    `ifdef EXCLUDE_LLC
    .AXI_ID_WIDTH   ( ariane_soc::IdWidthSlave   ),
    `else
    .AXI_ID_WIDTH   ( ariane_soc::IdWidthSlave+1 ),
    `endif
    .AXI_USER_WIDTH ( AXI_USER_WIDTH             )
   ) mem_axi_bus_slowdown_mst();

   AXI_LITE #(
    .AXI_ADDR_WIDTH (AXI_LITE_AW),
    .AXI_DATA_WIDTH (AXI_LITE_DW)
   ) llc_cfg_bus();

   AXI_LITE #(
    .AXI_ADDR_WIDTH (AXI_LITE_AW),
    .AXI_DATA_WIDTH (AXI_LITE_DW)
   ) axi_lite_pmu_32();

   AXI_LITE #(
    .AXI_ADDR_WIDTH ( AXI_ADDRESS_WIDTH ),
    .AXI_DATA_WIDTH ( AXI_DATA_WIDTH    )
   ) axi_lite_pmu_64();

  // APMU - Debug Request
   ariane_axi_soc::req_lite_t  pmu_master_req;
   ariane_axi_soc::resp_lite_t pmu_master_res;

   // APMU Configuration Signals
   ariane_axi_soc::req_lite_t  axi_lite_pmu_cfg_req;
   ariane_axi_soc::resp_lite_t axi_lite_pmu_cfg_res;

   // PERF COUNTERS EVU Configuration Signals
   ariane_axi_soc::req_lite_t  axi_lite_perfc_cfg_req;
   ariane_axi_soc::resp_lite_t axi_lite_perfc_cfg_resp;

   logic  [APMU_NUM_COUNTER-1:0] pmu_intr_o;
   // APMU event ports: element i is port i + 1 (ariane_soc::Apmu*Idx): the cores' EVUs, the SPUs on the cores' CCU
   // ports, the SPU on the LLC memory port, the SPU on the accelerator socket's DMA
   pmu_pkg::pmu_event_t [ariane_soc::ApmuNumPorts-1:0] spu_o;


   XBAR_TCDM_BUS axi_bridge_2_interconnect[AXI64_2_TCDM32_N_PORTS]();
   XBAR_TCDM_BUS udma_2_tcdm_channels[NB_UDMA_TCDM_CHANNEL]();


`ifndef SYNTHESIS
   axi_x_monitor #(.req_t(ariane_axi_soc::req_slv_t), .resp_t(ariane_axi_soc::resp_slv_t), .NAME("llc_in")) i_xmon_llc_in (.clk_i(s_soc_clk), .req_i(axi_cpu_req), .resp_i(axi_cpu_res));
   axi_x_monitor #(.req_t(ariane_axi_soc::req_slv_mem_t), .resp_t(ariane_axi_soc::resp_slv_mem_t), .NAME("llc_mem")) i_xmon_llc_mem (.clk_i(s_soc_clk), .req_i(axi_mem_req), .resp_i(axi_mem_res));
`endif
  `ifdef XSIM_SIM_DRAM
   // xsim: with NO_L3_CONNECTION no HyperRAM model sits on the pads, so an LLC refill never returns and the
   // CCU FSM blocks every core. Terminate mem_axi_bus (LLC -> SPU -> slowdown -> DRAM model -> HyperBus path) in a simulation memory
   // and give the HyperBus subsystem an idle bus instead.
   AXI_BUS #(
     .AXI_ADDR_WIDTH ( AXI_ADDRESS_WIDTH           ),
     .AXI_DATA_WIDTH ( AXI_DATA_WIDTH              ),
     .AXI_ID_WIDTH   ( ariane_soc::IdWidthSlave +1 ),
     .AXI_USER_WIDTH ( AXI_USER_WIDTH              )
   ) xsim_hyper_dummy_bus();
   assign xsim_hyper_dummy_bus.aw_valid = 1'b0;
   assign xsim_hyper_dummy_bus.ar_valid = 1'b0;
   assign xsim_hyper_dummy_bus.w_valid  = 1'b0;
   assign xsim_hyper_dummy_bus.b_ready  = 1'b1;
   assign xsim_hyper_dummy_bus.r_ready  = 1'b1;
   typedef logic [AXI_ADDRESS_WIDTH-1:0]      xsim_dram_addr_t;
   typedef logic [ariane_soc::IdWidthSlave:0] xsim_dram_id_t;
   typedef logic [AXI_DATA_WIDTH-1:0]         xsim_dram_data_t;
   typedef logic [AXI_DATA_WIDTH/8-1:0]       xsim_dram_strb_t;
   typedef logic [AXI_USER_WIDTH-1:0]         xsim_dram_user_t;
   `AXI_TYPEDEF_ALL(xsim_dram, xsim_dram_addr_t, xsim_dram_id_t, xsim_dram_data_t, xsim_dram_strb_t, xsim_dram_user_t)
   xsim_dram_req_t  [0:0] xsim_dram_req;
   xsim_dram_resp_t [0:0] xsim_dram_rsp;
   xsim_dram_req_t        xsim_llc_mem_req;
   xsim_dram_resp_t       xsim_llc_mem_rsp;
   `AXI_ASSIGN_TO_REQ(xsim_llc_mem_req, mem_axi_bus)
   `AXI_ASSIGN_FROM_RESP(mem_axi_bus, xsim_llc_mem_rsp)
   logic xsim_dram_clk, xsim_dram_rst_n;
  `ifdef XSIM_DRAM_IDEAL
   // memory answers in the SoC clock domain within a cycle or two
   assign xsim_dram_clk    = s_soc_clk;
   assign xsim_dram_rst_n  = s_synch_soc_rst;
   assign xsim_dram_req[0] = xsim_llc_mem_req;
   assign xsim_llc_mem_rsp = xsim_dram_rsp[0];
  `else
   // Board-like memory path (default). On the FPGA (fpga/ddr/alsaqr_xilinx.sv) the LLC memory port crosses into
   // the DDR4 controller's clock through an axi_cdc (LOG_DEPTH 4), and the controller answers after a variable
   // latency, so a read can overtake an earlier write (AXI orders nothing between AR and AW/W). Model both: the
   // same CDC into a 300 MHz clock, then random stalls (0-15 cycles per transfer) on every channel. Races that
   // only show up behind real DDR show up here too; XSIM_DRAM_IDEAL restores the direct connection.
   xsim_dram_req_t  xsim_cdc_req;
   xsim_dram_resp_t xsim_cdc_rsp;
   initial xsim_dram_clk = 1'b0;
   always #1667ps xsim_dram_clk = ~xsim_dram_clk;
   logic [1:0] xsim_dram_rst_q;
   always_ff @(posedge xsim_dram_clk or negedge s_synch_soc_rst)
     if (!s_synch_soc_rst) xsim_dram_rst_q <= '0;
     else                  xsim_dram_rst_q <= {xsim_dram_rst_q[0], 1'b1};
   assign xsim_dram_rst_n = xsim_dram_rst_q[1];
   axi_cdc #(
     .aw_chan_t  ( xsim_dram_aw_chan_t ),
     .w_chan_t   ( xsim_dram_w_chan_t  ),
     .b_chan_t   ( xsim_dram_b_chan_t  ),
     .ar_chan_t  ( xsim_dram_ar_chan_t ),
     .r_chan_t   ( xsim_dram_r_chan_t  ),
     .axi_req_t  ( xsim_dram_req_t     ),
     .axi_resp_t ( xsim_dram_resp_t    ),
     .LogDepth   ( 4                   )
   ) i_xsim_dram_cdc (
     .src_clk_i  ( s_soc_clk        ),
     .src_rst_ni ( s_synch_soc_rst  ),
     .src_req_i  ( xsim_llc_mem_req ),
     .src_resp_o ( xsim_llc_mem_rsp ),
     .dst_clk_i  ( xsim_dram_clk    ),
     .dst_rst_ni ( xsim_dram_rst_n  ),
     .dst_req_o  ( xsim_cdc_req     ),
     .dst_resp_i ( xsim_cdc_rsp     )
   );
   axi_delayer #(
     .aw_chan_t         ( xsim_dram_aw_chan_t ),
     .w_chan_t          ( xsim_dram_w_chan_t  ),
     .b_chan_t          ( xsim_dram_b_chan_t  ),
     .ar_chan_t         ( xsim_dram_ar_chan_t ),
     .r_chan_t          ( xsim_dram_r_chan_t  ),
     .axi_req_t         ( xsim_dram_req_t     ),
     .axi_resp_t        ( xsim_dram_resp_t    ),
     .StallRandomInput  ( 1'b1                ),
     .StallRandomOutput ( 1'b1                ),
     .FixedDelayInput   ( 0                   ),
     .FixedDelayOutput  ( 0                   )
   ) i_xsim_dram_delay (
     .clk_i      ( xsim_dram_clk    ),
     .rst_ni     ( xsim_dram_rst_n  ),
     .slv_req_i  ( xsim_cdc_req     ),
     .slv_resp_o ( xsim_cdc_rsp     ),
     .mst_req_o  ( xsim_dram_req[0] ),
     .mst_resp_i ( xsim_dram_rsp[0] )
   );
  `endif
   axi_sim_mem #(
     .AddrWidth         ( AXI_ADDRESS_WIDTH          ),
     .DataWidth         ( AXI_DATA_WIDTH             ),
     .IdWidth           ( ariane_soc::IdWidthSlave+1 ),
     .UserWidth         ( AXI_USER_WIDTH             ),
     .NumPorts          ( 1                          ),
     .axi_req_t         ( xsim_dram_req_t            ),
     .axi_rsp_t         ( xsim_dram_resp_t           ),
     .WarnUninitialized ( 1'b0                       ),
     .UninitializedData ( "zeros"                    ),
     .ApplDelay         ( 300ps                      ),
     .AcqDelay          ( 1500ps                     )
   ) i_xsim_sim_dram (
     .clk_i     ( xsim_dram_clk   ),
     .rst_ni    ( xsim_dram_rst_n ),
     .axi_req_i ( xsim_dram_req   ),
     .axi_rsp_o ( xsim_dram_rsp   ),
     .mon_w_valid_o (), .mon_w_addr_o (), .mon_w_data_o (), .mon_w_id_o (), .mon_w_user_o (), .mon_w_beat_count_o (), .mon_w_last_o (),
     .mon_r_valid_o (), .mon_r_addr_o (), .mon_r_data_o (), .mon_r_id_o (), .mon_r_user_o (), .mon_r_beat_count_o (), .mon_r_last_o ()
   );
   // The common startup code (software/common/syscalls.c) wakes the second core through the SCMI mailbox
   // with the hard-coded L3 entry 0x8000_0000. In the L2 flow nothing lives there, and an all-zero opcode is an
   // illegal instruction that CVA6 offloads to the absent CV-X-IF coprocessor and never commits, so the later
   // JTAG halt of that core can never be taken. Park it in a WFI loop there instead.
   initial begin
     i_xsim_sim_dram.mem[64'h8000_0000] = 8'h73; // wfi          = 0x10500073
     i_xsim_sim_dram.mem[64'h8000_0001] = 8'h00;
     i_xsim_sim_dram.mem[64'h8000_0002] = 8'h50;
     i_xsim_sim_dram.mem[64'h8000_0003] = 8'h10;
     i_xsim_sim_dram.mem[64'h8000_0004] = 8'h6f; // jal x0, -4   = 0xffdff06f
     i_xsim_sim_dram.mem[64'h8000_0005] = 8'hf0;
     i_xsim_sim_dram.mem[64'h8000_0006] = 8'hdf;
     i_xsim_sim_dram.mem[64'h8000_0007] = 8'hff;
   end
  `endif

  `ifdef XILINX_DDR
   AXI_BUS #(
     .AXI_ADDR_WIDTH ( AXI_ADDRESS_WIDTH           ),
     .AXI_DATA_WIDTH ( AXI_DATA_WIDTH              ),
     .AXI_ID_WIDTH   ( ariane_soc::IdWidthSlave +1 ),
     .AXI_USER_WIDTH ( AXI_USER_WIDTH              )
   ) dummyaxibus();
   assign dummyaxibus.aw_valid  = 1'b0;
   assign dummyaxibus.ar_valid  = 1'b0;
   assign dummyaxibus.w_valid   = 1'b0;


   `AXI_ASSIGN(axi_ddr_master,mem_axi_bus)
  `endif

  `ifdef EXCLUDE_LLC
   `AXI_ASSIGN(mem_axi_bus,hyper_axi_bus)
   assign s_dram_model_cnt = '0;   // no DRAM timing model without the LLC

   logic r_valid_d, r_valid_q;
   logic b_valid_d, b_valid_q;

   assign llc_cfg_bus.aw_ready = 1'b1;
   assign llc_cfg_bus.w_ready  = 1'b1;
   assign llc_cfg_bus.b_valid  = b_valid_q;
   assign llc_cfg_bus.b_resp   = 2'b0;
   assign llc_cfg_bus.ar_ready = 1'b1;
   assign llc_cfg_bus.r_data   = 32'hdeadf000;
   assign llc_cfg_bus.r_valid  = r_valid_q;

   assign s_llc_read_hit_cache   = 1'b0;
   assign s_llc_read_miss_cache  = 1'b0;
   assign s_llc_write_hit_cache  = 1'b0;
   assign s_llc_write_miss_cache = 1'b0;

   always_comb begin
      r_valid_d = r_valid_q;
      if(!r_valid_q && llc_cfg_bus.ar_valid)
        r_valid_d = 1'b1;
      else if(r_valid_q && llc_cfg_bus.r_ready)
        r_valid_d = 1'b0;
   end
   `FFARN(r_valid_q, r_valid_d, '0, s_soc_clk, s_synch_soc_rst)

   always_comb begin
      b_valid_d = b_valid_q;
      if(!b_valid_q && llc_cfg_bus.w_valid)
        b_valid_d = 1'b1;
      else if(b_valid_q && llc_cfg_bus.b_ready)
        b_valid_d = 1'b0;
   end
   `FFARN(b_valid_q, b_valid_d, '0, s_soc_clk, s_synch_soc_rst)

  `else

   `AXI_ASSIGN_TO_REQ(axi_cpu_req,hyper_axi_bus)
   `AXI_ASSIGN_FROM_RESP(hyper_axi_bus,axi_cpu_res)
   // Memory path after the LLC's memory port:
   //   LLC -> SPU (i_spu_llc_mem, APMU memory events) -> slowdown regulator (ip_list/slowdown, USE_SLOWDOWN)
   //       -> DRAM timing model -> DRAM path (mem_axi_bus)
   // The SPU sees each request as the LLC issues it and each response after the slowdown's and the model's delays.
   `ifdef APMU_IP
    // Converts request packets to AXI Bus signals.
    `AXI_ASSIGN_FROM_REQ( mem_axi_bus_spu_o_bus, axi_mem_req )
    `AXI_ASSIGN_TO_RESP( axi_mem_res, mem_axi_bus_spu_o_bus )
  `else
    // No SPU: the LLC feeds the slowdown directly.
    `AXI_ASSIGN_FROM_REQ( mem_axi_bus_spu_mst, axi_mem_req )
    `AXI_ASSIGN_TO_RESP( axi_mem_res, mem_axi_bus_spu_mst )
  `endif

  `ifdef USE_SLOWDOWN
   // Slowdown regulator between the SPU (post-LLC) and the DRAM timing model: caps the request rate and delays
   // every R/B response (hardware/ip_list/slowdown/README.md)
   slowdown_mem_top #(
    .Latency_param            ( 20 ),  // must be >= 2
    .Throughput_timer_param   ( 10 ),
    .Throughput_FIFO_depth    (  8 )
    // Throughput_COUNTER_WIDTH is a localparam ($clog2) inside the module
   ) i_slowdown (
    .clk_i            ( s_soc_clk                ),
    .rst_ni           ( s_synch_soc_rst          ),
    .slowdown_mem_slv ( mem_axi_bus_spu_mst      ),
    .slowdown_mem_mst ( mem_axi_bus_slowdown_mst )
   );
  `else
   `AXI_ASSIGN( mem_axi_bus_slowdown_mst, mem_axi_bus_spu_mst )
  `endif

   // DRAM timing model after the slowdown, in front of the DRAM path: a wire until it is enabled through the
   // SoC control registers at 0x1A10_6100 (hardware/docs/dram_model.md)
   `AXI_ASSIGN_TO_REQ( axi_model_req, mem_axi_bus_slowdown_mst )
   `AXI_ASSIGN_FROM_RESP( mem_axi_bus_slowdown_mst, axi_model_res )
   axi_dram_timing #(
     .axi_req_t  ( ariane_axi_soc::req_slv_mem_t    ),
     .axi_resp_t ( ariane_axi_soc::resp_slv_mem_t   ),
     .r_chan_t   ( ariane_axi_soc::r_chan_slv_mem_t ),
     .b_chan_t   ( ariane_axi_soc::b_chan_slv_mem_t ),
     .IdWidth    ( ariane_soc::IdWidthSlave + 1     )
   ) i_axi_dram_timing (
     .clk_i      ( s_soc_clk        ),
     .rst_ni     ( s_synch_soc_rst  ),
     .cfg_i      ( s_dram_model_cfg ),
     .cnt_o      ( s_dram_model_cnt ),
     .slv_req_i  ( axi_model_req    ),
     .slv_resp_o ( axi_model_res    ),
     .mst_req_o  ( axi_dram_req     ),
     .mst_resp_i ( axi_dram_res     )
   );
   // Converts request packets to AXI Bus signals.
   `AXI_ASSIGN_FROM_REQ( mem_axi_bus, axi_dram_req )
   `AXI_ASSIGN_TO_RESP( axi_dram_res, mem_axi_bus )
   `AXI_LITE_ASSIGN_TO_REQ(axi_llc_cfg_req,llc_cfg_bus)
   `AXI_LITE_ASSIGN_FROM_RESP(llc_cfg_bus,axi_llc_cfg_res)

    axi_llc_top #(
      .SetAssociativity ( ariane_soc::LLC_SET_ASSOC      ),
      .NumLines         ( ariane_soc::LLC_NUM_LINES      ),
      .NumBlocks        ( ariane_soc::LLC_NUM_BLOCKS     ),
      .AxiIdWidth       ( ariane_soc::IdWidthSlave       ),
      .AxiAddrWidth     ( AXI_ADDRESS_WIDTH              ),
      .AxiDataWidth     ( AXI_DATA_WIDTH                 ),
      .AxiUserWidth     ( AXI_USER_WIDTH                 ),
      .AxiLiteAddrWidth ( AXI_LITE_AW                    ),
      .AxiLiteDataWidth ( AXI_LITE_DW                    ),
      .slv_req_t        ( ariane_axi_soc::req_slv_t      ),
      .slv_resp_t       ( ariane_axi_soc::resp_slv_t     ),
      .mst_req_t        ( ariane_axi_soc::req_slv_mem_t  ),
      .mst_resp_t       ( ariane_axi_soc::resp_slv_mem_t ),
      .lite_req_t       ( ariane_axi_soc::req_lite_t     ),
      .lite_resp_t      ( ariane_axi_soc::resp_lite_t    ),
      .rule_full_t      ( rule_full_t                    ),
      // Source ID Specifications: per-source way masks indexed by the ID above the remapper's slot bits, {crossbar
      // port, the remapper's source prefix}, one mask per index value
      .SourceIDStart    ( ariane_soc::RemapSlotWidth     ),
      .SourceIDEnd      ( ariane_soc::IdWidthSlave-1     ),
      .NumCfgRegcp      ( 2**(ariane_soc::IdWidthSlave - ariane_soc::RemapSlotWidth) ),
      // CBQRI capacity controller at LLC config base + 0x800 (0x1040_1800): ways allocated per (RCID, AT) of the
      // QoS tag in the AXI user field (ariane_axi_soc layout, hardware/docs/qos.md)
      .QosRcidWidth     ( ariane_pkg::QOS_RCID_WIDTH     ),
      .QosRcidLsb       ( ariane_axi_soc::QosUserLsb     ),
      .QosAtBit         ( ariane_axi_soc::QosUserLsb + ariane_pkg::QOS_RCID_WIDTH + ariane_pkg::QOS_MCID_WIDTH ),
      .QosCcOffset      ( 32'h800                        )
    ) i_axi_llc (
      .clk_i               ( s_soc_clk                                                                           ),
      .rst_ni              ( s_synch_soc_rst                                                                     ),
      .test_i              ( 1'b0                                                                                ),
      .slv_req_i           ( axi_cpu_req                                                                         ),
      .slv_resp_o          ( axi_cpu_res                                                                         ),
      .mst_req_o           ( axi_mem_req                                                                         ),
      .mst_resp_i          ( axi_mem_res                                                                         ),
      .conf_req_i          ( axi_llc_cfg_req                                                                     ),
      .conf_resp_o         ( axi_llc_cfg_res                                                                     ),
      .cached_start_addr_i ( {{(AXI_ADDRESS_WIDTH-$bits(s_llc_cache_addr_start)){1'b0}}, s_llc_cache_addr_start} ),
      .cached_end_addr_i   ( {{(AXI_ADDRESS_WIDTH-$bits(s_llc_cache_addr_end)){1'b0}}  , s_llc_cache_addr_end  } ),
      .spm_start_addr_i    ( {{(AXI_ADDRESS_WIDTH-$bits(s_llc_spm_addr_start)){1'b0}}  , s_llc_spm_addr_start  } ),
      .axi_llc_events_o    ( llc_events                                                                          )
    );

   `ifndef SYNTHESIS
   // QoS tag scoreboard (ariane_axi_soc user layout, host/qos_monitor.sv): LLC requests against the cores'
   // requests, LLC refills / evictions against the LLC requests
   qos_monitor #(
     .Name     ( "llc_in"                                ),
     .Role     ( "llc_in"                                ),
     .LineBits ( $clog2(ariane_soc::LLC_NUM_BLOCKS * 8)  ),
     .SetBits  ( $clog2(ariane_soc::LLC_NUM_LINES)       ),
     .req_t  ( ariane_axi_soc::req_slv_t  ),
     .resp_t ( ariane_axi_soc::resp_slv_t )
   ) i_qos_mon_llc_in (
     .clk_i  ( s_soc_clk       ),
     .rst_ni ( s_synch_soc_rst ),
     .req_i  ( axi_cpu_req     ),
     .resp_i ( axi_cpu_res     )
   );
   qos_monitor #(
     .Name     ( "llc_out"                               ),
     .Role     ( "llc_out"                               ),
     .LineBits ( $clog2(ariane_soc::LLC_NUM_BLOCKS * 8)  ),
     .SetBits  ( $clog2(ariane_soc::LLC_NUM_LINES)       ),
     .req_t  ( ariane_axi_soc::req_slv_mem_t  ),
     .resp_t ( ariane_axi_soc::resp_slv_mem_t )
   ) i_qos_mon_llc_out (
     .clk_i             ( s_soc_clk                      ),
     .rst_ni            ( s_synch_soc_rst                ),
     .req_i             ( axi_mem_req                    ),
     .resp_i            ( axi_mem_res                    ),
     .llc_flush_evict_i ( llc_events.evict_flush.active  )
   );
   `endif

   assign s_llc_read_hit_cache = llc_events.hit_read_cache.active;
   assign s_llc_read_miss_cache = llc_events.miss_read_cache.active;
   assign s_llc_write_hit_cache = llc_events.hit_write_cache.active;
   assign s_llc_write_miss_cache = llc_events.miss_write_cache.active;

  `endif

   AXI_LITE #(
    .AXI_ADDR_WIDTH (AXI_LITE_AW),
    .AXI_DATA_WIDTH (AXI_LITE_DW)
   ) apmu_cfg_lite_bus();

  AXI_LITE #(
   .AXI_ADDR_WIDTH (AXI_LITE_AW),
   .AXI_DATA_WIDTH (AXI_LITE_DW)
  ) perfc_cfg_lite_bus();

   // AXI Bus: XBAR <=> AXI Cut (IOPMP Configuration Port)
   AXI_BUS #(
     .AXI_ADDR_WIDTH ( AXI_ADDRESS_WIDTH        ),
     .AXI_DATA_WIDTH ( AXI_DATA_WIDTH           ),
     .AXI_ID_WIDTH   ( ariane_soc::IdWidthSlave ),
     .AXI_USER_WIDTH ( AXI_USER_WIDTH           )
   ) iopmp_cp_cut ();

   AXI_BUS #(
     .AXI_ADDR_WIDTH ( AXI_ADDRESS_WIDTH        ),
     .AXI_DATA_WIDTH ( AXI_DATA_WIDTH           ),
     .AXI_ID_WIDTH   ( ariane_soc::IdWidthSlave ),
     .AXI_USER_WIDTH ( AXI_USER_WIDTH           )
   ) iopmp_cfg (); //to cva6_subsytem's inputs

   AXI_BUS #(
     .AXI_ADDR_WIDTH ( AXI_ADDRESS_WIDTH   ),
     .AXI_DATA_WIDTH ( AXI_DATA_WIDTH      ),
     .AXI_ID_WIDTH   ( ariane_soc::IdWidth ),
     .AXI_USER_WIDTH ( AXI_USER_WIDTH      )
   ) iopmp_mst (); //to cva6_subsytem's inputs

   AXI_BUS #(
     .AXI_ADDR_WIDTH ( AXI_ADDRESS_WIDTH   ),
     .AXI_DATA_WIDTH ( AXI_DATA_WIDTH      ),
     .AXI_ID_WIDTH   ( ariane_soc::IdWidth ),
     .AXI_USER_WIDTH ( AXI_USER_WIDTH      )
   ) iopmp_mst_cut (); //to cva6_subsytem's inputs

   AXI_BUS #(
     .AXI_ADDR_WIDTH ( AXI_ADDRESS_WIDTH   ),
     .AXI_DATA_WIDTH ( AXI_DATA_WIDTH      ),
     .AXI_ID_WIDTH   ( ariane_soc::IdWidth ),
     .AXI_USER_WIDTH ( AXI_USER_WIDTH      )
   ) axi_iopmp_rp ();

   AXI_BUS_EXT #(
     .AXI_ADDR_WIDTH ( AXI_ADDRESS_WIDTH   ),
     .AXI_DATA_WIDTH ( AXI_DATA_WIDTH      ),
     .AXI_ID_WIDTH   ( ariane_soc::IdWidth ),
     .AXI_USER_WIDTH ( AXI_USER_WIDTH      )
   ) axi_iopmp_rp_ext ();

   ariane_axi_soc::req_ext_t axi_iopmp_rp_ext_req;
   ariane_axi_soc::resp_t axi_iopmp_rp_ext_rsp;

   ariane_axi_soc::req_t  axi_iopmp_ip_req;
   ariane_axi_soc::resp_t axi_iopmp_ip_rsp;

   ariane_axi_soc::req_slv_t  axi_iopmp_cp_req;
   ariane_axi_soc::resp_slv_t axi_iopmp_cp_rsp;

  `REG_BUS_TYPEDEF_ALL(iopmp_reg, ariane_axi_soc::addr_t, ariane_axi_soc::data_t, ariane_axi_soc::strb_t)

  `ifdef APMU_IOPMP

  `AXI_ASSIGN_TO_REQ(axi_iopmp_cp_req, iopmp_cp_cut)
  `AXI_ASSIGN_FROM_RESP(iopmp_cp_cut, axi_iopmp_cp_rsp)

  `AXI_ASSIGN_FROM_REQ(iopmp_mst,axi_iopmp_ip_req)
  `AXI_ASSIGN_TO_RESP(axi_iopmp_ip_rsp, iopmp_mst)

  `AXI_LITE_ASSIGN_FROM_REQ(axi_lite_pmu_32,pmu_master_req)
  `AXI_LITE_ASSIGN_TO_RESP(pmu_master_res, axi_lite_pmu_32)

   // Manually assign extended signals

  `AXI_ASSIGN(axi_iopmp_rp_ext,axi_iopmp_rp)

  `AXI_ASSIGN_TO_REQ(axi_iopmp_rp_ext_req, axi_iopmp_rp_ext)
  `AXI_ASSIGN_FROM_RESP(axi_iopmp_rp_ext, axi_iopmp_rp_ext_rsp)

   assign axi_iopmp_rp_ext_req.aw.stream_id    = 24'd1;
   assign axi_iopmp_rp_ext_req.aw.ss_id_valid  = '0;
   assign axi_iopmp_rp_ext_req.aw.substream_id = '0;
   assign axi_iopmp_rp_ext_req.aw.nsaid        = 4'd1;

   assign axi_iopmp_rp_ext_req.ar.stream_id    = 24'd1;
   assign axi_iopmp_rp_ext_req.ar.ss_id_valid  = '0;
   assign axi_iopmp_rp_ext_req.ar.substream_id = '0;
   assign axi_iopmp_rp_ext_req.ar.nsaid        = 4'd1;

  `else // !`ifdef APMU_IOPMP

   `AXI_ASSIGN(iopmp_mst, axi_iopmp_rp)
   `AXI_LITE_ASSIGN_FROM_REQ(axi_lite_pmu_32,pmu_master_req)
   `AXI_LITE_ASSIGN_TO_RESP(pmu_master_res, axi_lite_pmu_32)

  `endif

  `ifdef APMU_IP
   localparam N_ADDR_RULES = 2;
   ariane_soc::addr_map_rule_t [N_ADDR_RULES-1:0]   spu_mem_addr_map;
   assign spu_mem_addr_map[0] = '{
         idx: 0,
         start_addr: ariane_soc::DebugBase,
         end_addr:   ariane_soc::HYAXIBase
   };

   assign spu_mem_addr_map[1] = '{
         idx: 1,
         start_addr: ariane_soc::HYAXIBase,
         end_addr:   ariane_soc::HYAXIBase + ariane_soc::HYAXILength
   };

   // Source of each request on the LLC memory port for the APMU (ariane_axi_soc::mem_src, ariane_soc::NumMemSrcs
   // codes): for CVA6-port traffic the CCU source in the user field (the cores, then the accelerator socket's and the
   // Ethernet's DMA ports), for every other crossbar master a code of its own. A response reports its request's.
   logic [ariane_soc::MemSrcWidth-1:0] spu_mem_ar_src, spu_mem_aw_src;
   assign spu_mem_ar_src = ariane_axi_soc::mem_src(mem_axi_bus_spu_o_bus.ar_id[ariane_soc::IdWidthSlave-1:0],
                                                   mem_axi_bus_spu_o_bus.ar_user);
   assign spu_mem_aw_src = ariane_axi_soc::mem_src(mem_axi_bus_spu_o_bus.aw_id[ariane_soc::IdWidthSlave-1:0],
                                                   mem_axi_bus_spu_o_bus.aw_user);
   // pragma translate_off
   initial begin : p_mem_src_assert
     assert (ariane_soc::MemSrcWidth == pmu_pkg::SOURCE_ID_BITS && ariane_soc::NumMemSrcs <= 2**ariane_soc::MemSrcWidth)
       else $fatal(1, "APMU memory-port sources: %0d codes in a %0d-bit field (pmu_pkg %0d bits)", ariane_soc::NumMemSrcs,
                   ariane_soc::MemSrcWidth, pmu_pkg::SOURCE_ID_BITS);
     // the LLC's per-source registers (64 + 8 bytes each, axi_llc_config) must stay below its CBQRI window (QosCcOffset)
     assert (64 + 8 * 2**(ariane_soc::IdWidthSlave - ariane_soc::RemapSlotWidth) <= 32'h800)
       else $fatal(1, "LLC: %0d per-source way masks overlap the CBQRI window", 2**(ariane_soc::IdWidthSlave - ariane_soc::RemapSlotWidth));
   end
   // pragma translate_on

   // The memory-port SPU's table (CAM_DEPTH) must hold every read and every write the LLC can have in flight on its
   // memory port, or the SPU silently stops tracking. The LLC's input (axi_isolate, NumPending = MaxTrans) holds back
   // a new read while MaxTrans reads wait for their last beat and a new write while MaxTrans writes wait for B, and the
   // LLC adds at most RefillFifoDepth + 2 refills and EvictFifoDepth + 2 evictions of its own: 10 + 4 + 2 = 16 in each
   // direction, at any core count; one more entry is spare. The path after the SPU (the slowdown's queue and delay,
   // the DRAM timing model's tables and buffers) could hold more, but the LLC never sends more.
   localparam int unsigned MemSpuCamDepth = axi_llc_pkg::MaxTrans + 2 + 1 +
     ((axi_llc_pkg::RefillFifoDepth > axi_llc_pkg::EvictFifoDepth) ? axi_llc_pkg::RefillFifoDepth
                                                                     : axi_llc_pkg::EvictFifoDepth);

`ifndef XSIM_CUT_i_spu_llc_mem // xsim bisect
axi_spu_top #(
     // Static configuration parameters of the cache.
     .SetAssociativity   ( ariane_soc::LLC_SET_ASSOC   ),
     .NumLines           ( ariane_soc::LLC_NUM_LINES   ),
     .NumBlocks          ( ariane_soc::LLC_NUM_BLOCKS  ),
     // Source ID Specifications: MemSrcWidth-bit sources from spu_mem_ar_src / spu_mem_aw_src
     .SourceIDStart      (  0                          ),
     .SourceIDEnd        (  ariane_soc::MemSrcWidth-1  ),
     .ExtSource          (  1'b1                       ),
     // AXI4 Specifications: the LLC memory port's full ID, so that its bypass and cache paths never alias
     .IdWidth            ( ariane_soc::IdWidthSlave+1  ),
     .AddrWidth          ( AXI_ADDRESS_WIDTH           ),
     .DataWidth          ( AXI_DATA_WIDTH              ),
     // Address Indexing
     .N_ADDR_RULES       ( N_ADDR_RULES                ),
     .addr_rule_t        ( ariane_soc::addr_map_rule_t ),
     // FIFO and CAM Parameters
     .CAM_DEPTH          ( MemSpuCamDepth              ),   // 17
     .FIFO_DEPTH         (  8                          )
   ) i_spu_llc_mem (
     .clk_i              ( s_soc_clk                   ),
     .rst_ni             ( s_synch_soc_rst             ),
     .addr_map_i         ( spu_mem_addr_map            ),
     .spu_slv            ( mem_axi_bus_spu_o_bus       ),
     .spu_mst            ( mem_axi_bus_spu_mst         ),  // SPU -> slowdown -> DRAM timing model -> memory
     .ar_src_i           ( spu_mem_ar_src              ),
     .aw_src_i           ( spu_mem_aw_src              ),
     .e_out              ( spu_o[ariane_soc::ApmuMemSpuIdx] )   // APMU port 2*NumCVA6+1
   );
`endif // XSIM_CUT_i_spu_llc_mem

   // AXI Cut for IOPMP Configuration Port
   axi_cut_intf #(
     .ADDR_WIDTH ( AXI_ADDRESS_WIDTH         ),
     .DATA_WIDTH ( AXI_DATA_WIDTH            ),
     .ID_WIDTH   ( ariane_soc::IdWidthSlave  ),
     .USER_WIDTH ( AXI_USER_WIDTH             )
   ) axi_iopmp_cp_cut (
     .clk_i  ( s_soc_clk       ),
     .rst_ni ( s_synch_soc_rst ),
     .in     ( iopmp_cfg       ),
     .out    ( iopmp_cp_cut    )
   );

   // AXI Cut for IOPMP Initiator Port
   axi_cut_intf #(
     .ADDR_WIDTH ( AXI_ADDRESS_WIDTH         ),
     .DATA_WIDTH ( AXI_DATA_WIDTH            ),
     .ID_WIDTH   ( ariane_soc::IdWidth       ),
     .USER_WIDTH ( AXI_USER_WIDTH             )
   ) axi_iopmp_ip_cut (
     .clk_i  ( s_soc_clk       ),
     .rst_ni ( s_synch_soc_rst ),
     .in     ( iopmp_mst       ),
     .out    ( iopmp_mst_cut   )
   );

`ifndef XSIM_CUT_i_riscv_iopmp // xsim bisect
   riscv_iopmp #(
     // AXI specific parameters
     .ADDR_WIDTH			   ( AXI_ADDRESS_WIDTH        ),
     .DATA_WIDTH			   ( AXI_DATA_WIDTH				    ),
     .ID_WIDTH			     ( ariane_soc::IdWidth	    ),
     .ID_SLV_WIDTH		   ( ariane_soc::IdWidthSlave ),
     .USER_WIDTH			   ( AXI_USER_WIDTH				    ),

     // AXI request/response
     .axi_req_nsaid_t    ( ariane_axi_soc::req_ext_t  ),
     .axi_req_t			     ( ariane_axi_soc::req_t	    ),
     .axi_rsp_t			     ( ariane_axi_soc::resp_t	    ),
     .axi_req_slv_t		   ( ariane_axi_soc::req_slv_t  ),
     .axi_rsp_slv_t		   ( ariane_axi_soc::resp_slv_t ),
     // AXI channel structs
     .axi_aw_chan_t      ( ariane_axi_soc::aw_chan_t  ),
     .axi_w_chan_t       ( ariane_axi_soc::w_chan_t	  ),
     .axi_b_chan_t       ( ariane_axi_soc::b_chan_t	  ),
     .axi_ar_chan_t      ( ariane_axi_soc::ar_chan_t  ),
     .axi_r_chan_t       ( ariane_axi_soc::r_chan_t	  ),

     // Register Interface parameters
     .reg_req_t		       ( iopmp_reg_req_t   ),
     .reg_rsp_t		       ( iopmp_reg_rsp_t   ),

     // Implementation specific
     .NUMBER_MDS         ( 16                ),
     .NUMBER_ENTRIES     ( 32                ),
     .NUMBER_MASTERS     ( 1                 )
   ) i_riscv_iopmp (
     .clk_i				       ( s_soc_clk             ),
     .rst_ni				     ( s_synch_soc_rst			 ),

     // AXI Config Slave port
     .control_req_i      ( axi_iopmp_cp_req      ),
     .control_rsp_o      ( axi_iopmp_cp_rsp      ),

     // AXI Bus Slave port
     .receiver_req_i     ( axi_iopmp_rp_ext_req  ),
     .receiver_rsp_o     ( axi_iopmp_rp_ext_rsp  ),

     // AXI Bus Master port
     .initiator_req_o    ( axi_iopmp_ip_req      ),
     .initiator_rsp_i    ( axi_iopmp_ip_rsp      ),

     .wsi_wire_o         ( iopmp_irq             ),
     .iopmp_lock_xor_key_i ( iopmp_lock_xor_key )
   );
`endif // XSIM_CUT_i_riscv_iopmp

   axi_lite_dw_converter_intf #(
     .AXI_ADDR_WIDTH          ( AXI_ADDRESS_WIDTH        ),
     .AXI_SLV_PORT_DATA_WIDTH ( AXI_LITE_DATA_WIDTH      ),
     .AXI_MST_PORT_DATA_WIDTH ( AXI_DATA_WIDTH           )
   ) axi_dw_conv_snooper (
     .clk_i  ( s_soc_clk        ),
     .rst_ni ( s_synch_soc_rst  ),
     .slv    ( axi_lite_pmu_32  ),
     .mst    ( axi_lite_pmu_64  )
   );

   axi_lite_to_axi_intf #(
     .AXI_DATA_WIDTH ( AXI_DATA_WIDTH   )
   ) axi_lite_to_axi_pmu (
     // Slave AXI LITE port
     .in              ( axi_lite_pmu_64 ),
    // NOTE: EMON: trying to see what is happening 
    //  .slv_aw_cache_i  ( '0              ),
    //  .slv_ar_cache_i  ( '0              ),
    .slv_aw_cache_i  ( 4'b0010         ),   // axi_pkg::CACHE_MODIFIABLE
    .slv_ar_cache_i  ( 4'b0010         ),
     .out             ( axi_iopmp_rp    )
   );

   // pragma translate_off
   initial begin : p_apmu_port_assert
     // an event select names a port by its PORT_ID 1..ApmuNumPorts in pmu_pkg::PORT_ID_BITS bits: a higher port
     // would count for a lower one (pmu_port compares the masked PORT_ID with the select's value)
     assert (ariane_soc::ApmuNumPorts < 2**pmu_pkg::PORT_ID_BITS)
       else $fatal(1, "APMU: %0d event ports, the %0d-bit PORT_ID names ports 1..%0d", ariane_soc::ApmuNumPorts,
                   pmu_pkg::PORT_ID_BITS, 2**pmu_pkg::PORT_ID_BITS - 1);
   end
   // pragma translate_on

   // The PMU only works with 32-bit AXI4-Lite port.
`ifndef XSIM_CUT_i_pmu_top // xsim bisect
   pmu_top #(
     .NUM_PORT         ( ariane_soc::ApmuNumPorts       ),
     .NUM_COUNTER      ( APMU_NUM_COUNTER               ),
     .ISPM_NUM_WORDS   ( 2048                           ),  // 8 KB size
     .DSPM_BASE_ADDR   ( 32'h1042_9000                    ),  // follows 8 KiB ISPM
     .DSPM_NUM_WORDS   ( 32768                           ),
    //  // APMU Addresses and SPM configuration
    //  .MEMORY_BASE_ADDR ( ariane_soc::L2SPMBase          ),
    //  .MEMORY_LENGTH    ( ariane_soc::L2SPMBase + ariane_soc::L2SPMLength        ),
    // // APMU Addresses and SPM configuration
     // the cores' EVU registers, the window the CPUs use too (ariane_soc: 0x100 bytes with four cores, 0x200 with eight)
     .MEMORY_BASE_ADDR ( ariane_soc::PerfcEvuBase     ),
     .MEMORY_LENGTH    ( ariane_soc::PerfcEvuLength   ),
     .req_lite_t       ( ariane_axi_soc::req_lite_t     ),
     .resp_lite_t      ( ariane_axi_soc::resp_lite_t    ),
     .aw_chan_lite_t   ( ariane_axi_soc::aw_chan_lite_t ),
     .w_chan_lite_t    ( ariane_axi_soc::w_chan_lite_t  ),
     .b_chan_lite_t    ( ariane_axi_soc::b_chan_lite_t  ),
     .ar_chan_lite_t   ( ariane_axi_soc::ar_chan_lite_t ),
     .r_chan_lite_t    ( ariane_axi_soc::r_chan_lite_t  )
   ) i_pmu_top (
     .clk_i            ( s_soc_clk                      ),
     .rst_ni           ( s_synch_soc_rst                ),
     .port_i           ( spu_o                          ),
     .conf_req_i       ( axi_lite_pmu_cfg_req           ),
     .conf_resp_o      ( axi_lite_pmu_cfg_res           ),
     .master_req_o     ( pmu_master_req                 ),
     .master_resp_i    ( pmu_master_res                 ),
     .intr_o           ( pmu_intr_o                     )
   );
`endif // XSIM_CUT_i_pmu_top

  `AXI_LITE_ASSIGN_TO_REQ( axi_lite_pmu_cfg_req, apmu_cfg_lite_bus    )
  `AXI_LITE_ASSIGN_FROM_RESP( apmu_cfg_lite_bus, axi_lite_pmu_cfg_res )

  `AXI_LITE_ASSIGN_TO_REQ( axi_lite_perfc_cfg_req, perfc_cfg_lite_bus    )
  `AXI_LITE_ASSIGN_FROM_RESP( perfc_cfg_lite_bus, axi_lite_perfc_cfg_resp)
  `endif

`ifndef XSIM_CUT_i_cva6_subsystem // xsim bisect
 `ifdef XSIM_V_CLK
  logic xsim_plain_clk = 1'b0; always #2000 xsim_plain_clk = ~xsim_plain_clk;
`endif
  cva6_subsystem # (
        .NUM_WORDS         ( NUM_WORDS      ),
        .AXI_USER_WIDTH    ( AXI_USER_WIDTH ),
        .APMU_NUM_COUNTER  ( APMU_NUM_COUNTER ),
        .InclSimDTM        ( 1'b1           ),
        .StallRandomOutput ( 1'b1           ),
        .StallRandomInput  ( 1'b1           ),
        .JtagEnable        ( JtagEnable     ),
        .axi_req_t         ( axi_req_t      ),
        .axi_rsp_t         ( axi_rsp_t      )
   ) i_cva6_subsystem (
`ifdef XSIM_V_CLK
    .clk_i(xsim_plain_clk),
`else
        .clk_i(s_soc_clk),
`endif
`ifdef XSIM_V_RST
    .rst_ni(1'b0),
`else
        .rst_ni(s_synch_global_rst),
`endif
        .cva6_clk_i(s_clk_cva6),
`ifdef XSIM_V_RST
    .cva6_rst_ni(1'b0),
`else
        .cva6_rst_ni(s_rstn_cva6_sync),
`endif
        .rtc_i,
        .jtag_TCK,
        .jtag_TMS,
        .jtag_TDI,
        .jtag_TRSTn,
        .jtag_TDO_data,
        .jtag_TDO_driven,
        .ot_axi_req,
        .ot_axi_rsp,
`ifdef XSIM_V_IN
    .irq_mbox_i('0),
`else
        .irq_mbox_i            ( completion_irq_o      ),
`endif
        .snoop_trigger_irq_o   ( cfi_req_irq_o         ),
        .snoop_watermark_irq_o ( snoop_watermark_irq_o ),
`ifdef XSIM_V_RST
    .sync_rst_ni(1'b0),
`else
        .sync_rst_ni           ( s_synch_soc_rst       ),
`endif
`ifdef XSIM_V_IN
    .udma_events_i('0),
`else
        .udma_events_i         ( s_udma_events         ),
`endif
        .cluster_eoc_i         ( cluster_eoc_i         ),
`ifdef XSIM_V_IN
    .c2h_irq_i('0),
`else
        .c2h_irq_i             ( s_c2h_irq             ),
`endif
`ifdef XSIM_V_IN
    .can_irq_i('0),
`else
        .can_irq_i             ( s_can_irq             ),
`endif
`ifdef XSIM_V_IN
    .pwm_irq_i('0),
`else
        .pwm_irq_i             ( s_pwm_irq             ),
`endif
`ifdef XSIM_V_IN
    .gpio_irq_i('0),
`else
        .gpio_irq_i            ( s_gpio_irq            ),
`endif
`ifdef XSIM_V_IN
    .cl_dma_pe_evt_i('0),
`else
        .cl_dma_pe_evt_i       ( s_dma_pe_evt          ),
`endif
        .dm_rst_o              ( s_dm_rst              ),
        .l2_axi_master         ( l2_axi_bus            ),
        .apb_axi_master        ( apb_axi_bus           ),
        .hyper_axi_master      ( hyper_axi_bus         ),
        .pmu_axi_slave         ( iopmp_mst_cut         ),
        .iopmp_axi_master      ( iopmp_cfg             ),

        //Ethernet
        .eth_clk_i            ( s_eth_clk_i          ), // 125 MHz 90
        .eth_phy_tx_clk_i     ( s_eth_phy_tx_clk_i   ), // 125 MHz 0
        .eth_clk_200MHz_i     ( s_eth_clk_200MHz_i   ),
        .eth_to_pad           ( eth_to_pad           ),
        .pad_to_eth           ( pad_to_eth           ),
        .xeth_to_pad          ( xeth_to_pad          ),
        .pad_to_xeth          ( pad_to_xeth          ),

        .cluster_axi_master   ( cluster_axi_master   ),
        .cluster_axi_slave    ( cluster_axi_slave    ),

        .udma_rx_l3_axi_slave ( udma_rx_l3_axi_bus   ),
        .udma_tx_l3_axi_slave ( udma_tx_l3_axi_bus   ),

        // EVU 
        .spu_core_o           ( spu_o[ariane_soc::ApmuCoreSpuIdx +: ariane_soc::NumCVA6]),
        .spu_accel_o          ( spu_o[ariane_soc::ApmuAccelSpuIdx] ),
        // APMU
`ifdef XSIM_V_IN
    .pmu_intr_i('0),
`else
        .pmu_intr_i           ( pmu_intr_o           ),
`endif
`ifdef XSIM_V_IN
    .iopmp_irq_i('0),
`else
        .iopmp_irq_i          ( iopmp_irq            ),

`endif
        .cva6_uart_rx_i       ( cva6_uart_rx_i       ),
        .cva6_uart_tx_o       ( cva6_uart_tx_o       ),
        .axi_lite_master      ( host_lite_bus        ),
        .axi_lite_snoop_req_i ( axi_lite_snooper_req ),
        .axi_lite_snoop_rsp_o ( axi_lite_snooper_rsp ),
`ifdef XSIM_V_IN
    .iommu_lock_xor_key_i('0),
`else

        .iommu_lock_xor_key_i ( iommu_lock_xor_key   ),
`endif
`ifdef XSIM_V_IN
    .aia_lock_xor_key_i('0),
`else
        .aia_lock_xor_key_i   ( aia_lock_xor_key     ),
`endif
        .perfc_cfg_req_i       ( axi_lite_perfc_cfg_req  ),
        .perfc_cfg_resp_o       ( axi_lite_perfc_cfg_resp ),
        .perfc_evu_status_resp_o( spu_o[ariane_soc::ApmuEvuIdx +: ariane_soc::NumCVA6]) 
    );
`endif // XSIM_CUT_i_cva6_subsystem

`ifndef XSIM_CUT_i_axi2mem_l2 // xsim bisect
   axi2tcdm_wrap #(
      .AXI_ID_WIDTH   ( ariane_soc::IdWidthSlave ),
      .AXI_USER_WIDTH ( AXI_USER_WIDTH           ),
      .AXI_ADDR_WIDTH ( AXI_ADDRESS_WIDTH        )
   ) i_axi2mem_l2 (
      .clk_i       ( s_soc_clk                 ),
      .rst_ni      ( s_synch_soc_rst           ),
      .test_en_i   ( test_en                   ),
      .axi_slave   ( l2_axi_bus                ),
      .tcdm_master ( axi_bridge_2_interconnect ),
      .busy_o      (                           )
   );
`endif // XSIM_CUT_i_axi2mem_l2


`ifndef XSIM_CUT_i_l2_subsystem // xsim bisect
   l2_subsystem #(
      .NB_L2_BANKS        ( NB_L2_BANKS              ),
      .L2_BANK_SIZE       ( L2_BANK_SIZE             ),
      .L2_BANK_ADDR_WIDTH ( L2_BANK_ADDR_WIDTH       ),
      .L2_DATA_WIDTH      ( L2_DATA_WIDTH            )
     ) i_l2_subsystem   (
      .clk_i                     ( s_soc_clk                 ),
      .rst_ni                    ( s_synch_soc_rst           ),
      .axi_bridge_2_interconnect ( axi_bridge_2_interconnect ),
      .udma_tcdm_channels        ( udma_2_tcdm_channels      )
     );
`endif // XSIM_CUT_i_l2_subsystem

    edge_propagator_rx ep_dma_pe_evt_i (
        .clk_i   ( s_soc_clk               ),
        .rstn_i  ( s_rstn_cluster_sync     ),
        .valid_o ( s_dma_pe_evt            ),
        .ack_o   ( dma_pe_evt_ack_o        ),
        .valid_i ( dma_pe_evt_valid_i      )
    );

   apb_subsystem #(
       .AXI_ADDR_WIDTH ( AXI_ADDRESS_WIDTH        ),
       .AXI_DATA_WIDTH ( AXI_DATA_WIDTH           ),
       .AXI_USER_WIDTH ( AXI_USER_WIDTH           ),
       .NUM_GPIO       ( NUM_GPIO                 ),
     `ifdef TARGET_SYNTHESIS
       .InclUART       ( 1'b1                     )
     `else
       .InclUART       ( 1'b0                     )
     `endif
     ) i_apb_subsystem (
      .clk_i                  ( s_soc_clk                      ),
      .rtc_i                  ( rtc_i                          ),
      .rst_ni                 ( rst_ni                         ),
      .bypass_clk_i           ( bypass_clk_i                   ),
      .rst_dm_i               ( s_dm_rst                       ),
      .clk_cva6_o             ( s_clk_cva6                     ),
      .clk_soc_o              ( s_soc_clk                      ),
      .s_clk_per_o            ( s_periph_clk                   ),
      .clk_opentitan_o        ( clk_opentitan_o                ),
      .rstn_soc_sync_o        ( s_synch_soc_rst                ),
      .rstn_global_sync_o     ( s_synch_global_rst             ),
      .rstn_cva6_sync_o       ( s_rstn_cva6_sync               ),
      .rstn_cluster_sync_o    ( s_rstn_cluster_sync            ),
      .clk_cluster_o          ( clk_cluster_o                  ),
      .cluster_en_sa_boot_o   ( cluster_en_sa_boot_o           ),
      .cluster_fetch_en_o     ( cluster_fetch_en_o             ),
      .llc_cache_addr_start_o ( s_llc_cache_addr_start         ),
      .llc_cache_addr_end_o   ( s_llc_cache_addr_end           ),
      .llc_spm_addr_start_o   ( s_llc_spm_addr_start           ),
      .llc_read_hit_cache_i   ( s_llc_read_hit_cache           ),
      .llc_read_miss_cache_i  ( s_llc_read_miss_cache          ),
      .llc_write_hit_cache_i  ( s_llc_write_hit_cache          ),
      .llc_write_miss_cache_i ( s_llc_write_miss_cache         ),
      .dram_model_cfg_o       ( s_dram_model_cfg               ),
      .dram_model_cnt_i       ( s_dram_model_cnt               ),

      `ifdef XILINX_DDR
      .hyper_axi_bus_slave    ( dummyaxibus                    ),
      `elsif XSIM_SIM_DRAM
      .hyper_axi_bus_slave    ( xsim_hyper_dummy_bus           ),
      `else
      .hyper_axi_bus_slave    ( mem_axi_bus                    ),
      `endif
      .axi_apb_slave          ( apb_axi_bus                    ),
      .udma_tcdm_channels     ( udma_2_tcdm_channels           ),
      .udma_rx_l3_axi_master  ( udma_rx_l3_axi_bus             ),
      .udma_tx_l3_axi_master  ( udma_tx_l3_axi_bus             ),

      .padframecfg_reg_master ( padframecfg_reg_master         ),

      .events_o               ( s_udma_events                  ),
      .can_irq_o              ( s_can_irq                      ),
      .pwm_irq_o              ( s_pwm_irq                      ),
      .gpio_irq_o             ( s_gpio_irq                     ),
      .spi_to_pad             ( spi_to_pad                     ),
      .pad_to_spi             ( pad_to_spi                     ),
      .qspi_to_pad            ( qspi_to_pad                    ),
      .pad_to_qspi            ( pad_to_qspi                    ),
      .i2c_to_pad             ( i2c_to_pad                     ),
      .pad_to_i2c             ( pad_to_i2c                     ),
  	  .pad_to_cam             ( pad_to_cam                     ),
      .uart_to_pad            ( uart_to_pad                    ),
      .pad_to_uart            ( pad_to_uart                    ),
      .usart_to_pad           ( usart_to_pad                   ),
      .pad_to_usart           ( pad_to_usart                   ),
      .sdio_to_pad            ( sdio_to_pad                    ),
      .pad_to_sdio            ( pad_to_sdio                    ),
      .pwm_to_pad             ( pwm_to_pad                     ),
      .can_to_pad             ( can_to_pad                     ),
      .pad_to_can             ( pad_to_can                     ),

      `ifndef XILINX_DDR
      .pad_hyper_csn,
      .pad_hyper_ck,
      .pad_hyper_ckn,
      .pad_hyper_rwds,
      .pad_hyper_reset,
      .pad_hyper_dq,
      `endif

      .fll_to_pad             ( fll_to_pad                     ),
      .gpio_to_pad            ( gpio_to_pad                    ),
      .pad_to_gpio            ( pad_to_gpio                    ),

      .cluster_lock_xor_key_o ( cluster_lock_xor_key_o         ),
      .iopmp_lock_xor_key_o   ( iopmp_lock_xor_key             ),
      .iommu_lock_xor_key_o   ( iommu_lock_xor_key             ),
      .aia_lock_xor_key_o     ( aia_lock_xor_key               )

      );


`ifndef XSIM_CUT_i_axi_lite_subsystem // xsim bisect
   axi_lite_subsystem #(
       .AXI_USER_WIDTH      ( AXI_USER_WIDTH    ),
       .AXI_ADDR_WIDTH      ( AXI_ADDRESS_WIDTH ),
       .AXI_DATA_WIDTH      ( AXI_DATA_WIDTH    ),
       .AXI_LITE_ADDR_WIDTH ( AXI_LITE_AW       ),
       .AXI_LITE_DATA_WIDTH ( AXI_LITE_DW       )
   ) i_axi_lite_subsystem (
       .clk_i                  ( s_soc_clk               ),
       .rst_ni                 ( rst_ni                  ),
       .host_axi_lite_slave    ( host_lite_bus           ),
       .cluster_axi_lite_slave ( cluster_lite_slave      ),
       .c2h_tlb_cfg_master     ( c2h_tlb_cfg_lite_master ),
       .llc_cfg_master         ( llc_cfg_bus             ),
       // APMU
       .apmu_cfg_master        ( apmu_cfg_lite_bus       ),
       .h2c_irq_o              ( h2c_irq_o               ),
       .c2h_irq_o              ( s_c2h_irq               ),
       .axi_lite_snoop_req_o   ( axi_lite_snooper_req    ),
       .axi_lite_snoop_rsp_i   ( axi_lite_snooper_rsp    ),
       .doorbell_irq_o,
       .completion_irq_o,
       .perfc_cfg_master      ( perfc_cfg_lite_bus     )
   );
`endif // XSIM_CUT_i_axi_lite_subsystem

endmodule
