Rodolfo-Pellizzoni-Lab/he-soc/hardware/host/axi_lite_subsystem.sv

// Copyright 2018 ETH Zurich and University of Bologna.
// Copyright and related rights are licensed under the Solderpad Hardware
// License, Version 0.51 (the "License"); you may not use this file except in
// compliance with the License.  You may obtain a copy of the License at
// http://solderpad.org/licenses/SHL-0.51. Unless required by applicable law
// or agreed to in writing, software, hardware and materials distributed under
// this License is distributed on an "AS IS" BASIS, WITHOUT WARRANTIES OR
// CONDITIONS OF ANY KIND, either express or implied. See the License for the
// specific language governing permissions and limitations under the License.
//
// Author: Florian Zaruba, ETH Zurich
// Date: 19.03.2017
// Description: Test-harness for Ariane
//              Instantiates an AXI-Bus and memories

`include "axi/assign.svh"
`include "axi/typedef.svh"
`define APMU_IP

module axi_lite_subsystem
  import ariane_soc::*;
  import ariane_axi_soc::*;
  import axi_pkg::*;
#(
    parameter int unsigned AXI_USER_WIDTH = 1,
    parameter int unsigned AXI_ADDR_WIDTH = 64,
    parameter int unsigned AXI_DATA_WIDTH = 64,
    parameter int unsigned AXI_LITE_ADDR_WIDTH = 32,
    parameter int unsigned AXI_LITE_DATA_WIDTH = 32
) (
    input logic      clk_i,
    input logic      rst_ni,

    AXI_BUS.Slave    host_axi_lite_slave,
    AXI_BUS.Slave    cluster_axi_lite_slave,

    AXI_LITE.Master  c2h_tlb_cfg_master,
    AXI_LITE.Master  llc_cfg_master,

    output req_lite_t  axi_lite_snoop_req_o,
    input  resp_lite_t axi_lite_snoop_rsp_i,
    // Master to the APMU Slave port.
    AXI_LITE.Master  apmu_cfg_master,
    // Performance Counters EVU AXI Lite Master
    AXI_LITE.Master  perfc_cfg_master,

    output logic     h2c_irq_o,
    output logic     c2h_irq_o,

    // doorbell irq to Ibex
    // completion irq to CVA6
    output logic     doorbell_irq_o,
    output logic     completion_irq_o
);

   logic             s_c2h_irq;

   ariane_axi_soc::req_lite_t llc_cfg_req,
                              h2c_tlb_cfg_req,
                              c2h_tlb_cfg_req,
                              host_lite_req,
                              cluster_lite_req,
                              h2cmailbox_lite_req,
                              c2hmailbox_lite_req,
                              axi_lite_mbox_req;

   ariane_axi_soc::resp_lite_t llc_cfg_resp,
                               h2c_tlb_cfg_resp,
                               c2h_tlb_cfg_resp,
                               host_lite_resp,
                               cluster_lite_resp,
                               h2cmailbox_lite_resp,
                               c2hmailbox_lite_resp,
                               axi_lite_mbox_rsp;

  ariane_axi_soc::req_lite_t  apmu_cfg_req;         // Connects to APMU-Slave device.
  ariane_axi_soc::resp_lite_t apmu_cfg_resp;

  AXI_LITE #(
    .AXI_ADDR_WIDTH (AXI_LITE_ADDR_WIDTH),
    .AXI_DATA_WIDTH (AXI_LITE_DATA_WIDTH)
  ) cluster_axi_lite_xbar_master();

  AXI_LITE #(
    .AXI_ADDR_WIDTH (AXI_LITE_ADDR_WIDTH),
    .AXI_DATA_WIDTH (AXI_LITE_DATA_WIDTH)
  ) host_axi_lite_xbar_master();

  AXI_BUS #(
     .AXI_ADDR_WIDTH ( AXI_ADDR_WIDTH           ),
     .AXI_DATA_WIDTH ( AXI_LITE_DATA_WIDTH      ),
     .AXI_ID_WIDTH   ( ariane_soc::IdWidthSlave ),
     .AXI_USER_WIDTH ( AXI_USER_WIDTH           )
  ) host_axi_lite_32 ();

  AXI_BUS #(
     .AXI_ADDR_WIDTH ( AXI_ADDR_WIDTH           ),
     .AXI_DATA_WIDTH ( AXI_LITE_DATA_WIDTH      ),
     .AXI_ID_WIDTH   ( ariane_soc::IdWidthSlave ),
     .AXI_USER_WIDTH ( AXI_USER_WIDTH           )
  ) cluster_axi_lite_32 ();

  axi_dw_converter_intf #(
    .AXI_ID_WIDTH             ( ariane_soc::IdWidthSlave ),
    .AXI_ADDR_WIDTH           ( AXI_ADDR_WIDTH           ),
    .AXI_SLV_PORT_DATA_WIDTH  ( AXI_DATA_WIDTH           ),
    .AXI_MST_PORT_DATA_WIDTH  ( AXI_LITE_DATA_WIDTH      ),
    .AXI_USER_WIDTH           ( AXI_USER_WIDTH           ),
    .AXI_MAX_READS            ( 1                        )
  ) i_dwc_host (
    .clk_i        ( clk_i               ),
    .rst_ni       ( rst_ni              ),
    .slv          ( host_axi_lite_slave ),
    .mst          ( host_axi_lite_32    )
  );

  axi_to_axi_lite_intf #(
    .AXI_ADDR_WIDTH     ( AXI_ADDR_WIDTH           ),
    .AXI_DATA_WIDTH     ( AXI_LITE_DATA_WIDTH      ),
    .AXI_ID_WIDTH       ( ariane_soc::IdWidthSlave ),
    .AXI_USER_WIDTH     ( AXI_USER_WIDTH           ),
    .AXI_MAX_WRITE_TXNS ( 1                        ),
    .AXI_MAX_READ_TXNS  ( 1                        ),
    .FALL_THROUGH       ( 1'b0                     )
  ) i_axi_to_axi_lite_host (
    .clk_i       ( clk_i                     ),
    .rst_ni      ( rst_ni                    ),
    .testmode_i  ( 1'b0                      ),
    .slv         ( host_axi_lite_32          ),
    .mst         ( host_axi_lite_xbar_master )
  );

  axi_dw_converter_intf #(
    .AXI_ID_WIDTH             ( ariane_soc::IdWidthSlave ),
    .AXI_ADDR_WIDTH           ( AXI_ADDR_WIDTH           ),
    .AXI_SLV_PORT_DATA_WIDTH  ( AXI_DATA_WIDTH           ),
    .AXI_MST_PORT_DATA_WIDTH  ( AXI_LITE_DATA_WIDTH      ),
    .AXI_USER_WIDTH           ( AXI_USER_WIDTH           ),
    .AXI_MAX_READS            ( 1                        )
  ) i_dwc_cluster (
    .clk_i        ( clk_i                  ),
    .rst_ni       ( rst_ni                 ),
    .slv          ( cluster_axi_lite_slave ),
    .mst          ( cluster_axi_lite_32    )
  );

  axi_to_axi_lite_intf #(
    .AXI_ADDR_WIDTH     ( AXI_ADDR_WIDTH           ),
    .AXI_DATA_WIDTH     ( AXI_LITE_DATA_WIDTH      ),
    .AXI_ID_WIDTH       ( ariane_soc::IdWidthSlave ),
    .AXI_USER_WIDTH     ( AXI_USER_WIDTH           ),
    .AXI_MAX_WRITE_TXNS ( 1                        ),
    .AXI_MAX_READ_TXNS  ( 1                        ),
    .FALL_THROUGH       ( 1'b0                     )
  ) i_axi_to_axi_lite_cluster (
    .clk_i       ( clk_i                        ),
    .rst_ni      ( rst_ni                       ),
    .testmode_i  ( 1'b0                         ),
    .slv         ( cluster_axi_lite_32          ),
    .mst         ( cluster_axi_lite_xbar_master )
  );

  `AXI_LITE_ASSIGN_TO_REQ    ( host_lite_req, host_axi_lite_xbar_master   )
  `AXI_LITE_ASSIGN_FROM_RESP ( host_axi_lite_xbar_master , host_lite_resp )

  `AXI_LITE_ASSIGN_TO_REQ    ( cluster_lite_req, cluster_axi_lite_xbar_master  )
  `AXI_LITE_ASSIGN_FROM_RESP ( cluster_axi_lite_xbar_master, cluster_lite_resp )

  `AXI_LITE_ASSIGN_FROM_REQ ( c2h_tlb_cfg_master     , c2h_tlb_cfg_req )
  `AXI_LITE_ASSIGN_TO_RESP  ( c2h_tlb_cfg_resp, c2h_tlb_cfg_master     )

  `AXI_LITE_ASSIGN_FROM_REQ ( llc_cfg_master , llc_cfg_req  )
  `AXI_LITE_ASSIGN_TO_RESP  ( llc_cfg_resp , llc_cfg_master )

  `AXI_LITE_ASSIGN_FROM_REQ ( apmu_cfg_master , apmu_cfg_req  )
  `AXI_LITE_ASSIGN_TO_RESP  ( apmu_cfg_resp , apmu_cfg_master )

`ifdef APMU_IP
  typedef axi_pkg::xbar_rule_32_t tlb_cfg_xbar_rule_t;

  ariane_axi_soc::resp_lite_t    events_cfg_perfc_resp;
  ariane_axi_soc::req_lite_t     events_cfg_perfc_req;

  `AXI_LITE_ASSIGN_FROM_REQ ( perfc_cfg_master, events_cfg_perfc_req)
  `AXI_LITE_ASSIGN_TO_RESP  ( events_cfg_perfc_resp, perfc_cfg_master)

  localparam axi_pkg::xbar_cfg_t FromHostTlbCfgXbarCfg = '{
    NoSlvPorts:  2,
    NoMstPorts:  8,
    MaxMstTrans: 2,
    MaxSlvTrans: 5,
    FallThrough: 0,
    LatencyMode: axi_pkg::CUT_SLV_AX,
    PipelineStages: 32'd0,
    AxiIdWidthSlvPorts: 1,
    AxiIdUsedSlvPorts: 1,
    UniqueIds   : 0,
    AxiAddrWidth: AXI_LITE_ADDR_WIDTH,
    AxiDataWidth: AXI_LITE_DATA_WIDTH,
    NoAddrRules: 8
  };

  localparam tlb_cfg_xbar_rule_t [FromHostTlbCfgXbarCfg.NoAddrRules-1:0]
      FromHostTlbCfgXbarAddrMap = '{
    '{idx: 32'd7, start_addr: 32'h1060_6000, end_addr: 32'h1060_6100},  // PerfCountersEVU
    '{idx: 32'd6, start_addr: 32'h1060_5000, end_addr: 32'h1060_6000},  // Snooper
    '{idx: 32'd5, start_addr: 32'h1040_5000, end_addr: 32'h1060_5000},  // APMU IP
    '{idx: 32'd4, start_addr: 32'h1040_4000, end_addr: 32'h1040_5000},
    '{idx: 32'd3, start_addr: 32'h1040_3000, end_addr: 32'h1040_4000},
    '{idx: 32'd2, start_addr: 32'h1040_2000, end_addr: 32'h1040_3000},
    '{idx: 32'd1, start_addr: 32'h1040_1000, end_addr: 32'h1040_2000},
    '{idx: 32'd0, start_addr: 32'h1040_0000, end_addr: 32'h1040_1000}   // Debug IP
  };

  axi_lite_xbar #(
     .Cfg                   ( FromHostTlbCfgXbarCfg          ),
     .aw_chan_t             ( ariane_axi_soc::aw_chan_lite_t ),
     .w_chan_t              ( ariane_axi_soc::w_chan_lite_t  ),
     .b_chan_t              ( ariane_axi_soc::b_chan_lite_t  ),
     .ar_chan_t             ( ariane_axi_soc::ar_chan_lite_t ),
     .r_chan_t              ( ariane_axi_soc::r_chan_lite_t  ),
     .axi_req_t             ( ariane_axi_soc::req_lite_t     ),
     .axi_resp_t            ( ariane_axi_soc::resp_lite_t    ),
     .rule_t                ( tlb_cfg_xbar_rule_t            )
   ) i_axi_lite_xbar         (
     .clk_i                 ( clk_i                                               ),
     .rst_ni                ( rst_ni                                              ),
     .test_i                ( 1'b0                                                ),
     .slv_ports_req_i       ( {cluster_lite_req , host_lite_req }                 ),
     .slv_ports_resp_o      ( {cluster_lite_resp, host_lite_resp}                 ),
     .mst_ports_req_o       ( { events_cfg_perfc_req, axi_lite_snoop_req_o, apmu_cfg_req,  axi_lite_mbox_req, c2hmailbox_lite_req,  h2cmailbox_lite_req,  llc_cfg_req,  c2h_tlb_cfg_req } ),
     .mst_ports_resp_i      ( { events_cfg_perfc_resp, axi_lite_snoop_rsp_i, apmu_cfg_resp, axi_lite_mbox_rsp, c2hmailbox_lite_resp, h2cmailbox_lite_resp, llc_cfg_resp, c2h_tlb_cfg_resp } ),
     .addr_map_i            ( FromHostTlbCfgXbarAddrMap                           ),
     .en_default_mst_port_i ( {1'b0, 1'b0}                                        ),
     .default_mst_port_i    ( '0                                                  )
   );
`else
  typedef axi_pkg::xbar_rule_32_t tlb_cfg_xbar_rule_t;

  localparam axi_pkg::xbar_cfg_t FromHostTlbCfgXbarCfg = '{
    NoSlvPorts:  2,
    NoMstPorts:  6,
    MaxMstTrans: 2,
    MaxSlvTrans: 6,
    FallThrough: 0,
    LatencyMode: axi_pkg::CUT_SLV_AX,
    PipelineStages: 32'd0,
    AxiIdWidthSlvPorts: 1,
    AxiIdUsedSlvPorts: 1,
    UniqueIds   : 0,
    AxiAddrWidth: AXI_LITE_ADDR_WIDTH,
    AxiDataWidth: AXI_LITE_DATA_WIDTH,
    NoAddrRules: 6
  };

  localparam tlb_cfg_xbar_rule_t [FromHostTlbCfgXbarCfg.NoAddrRules-1:0]
      FromHostTlbCfgXbarAddrMap = '{
    '{idx: 32'd5, start_addr: 32'h1060_5000, end_addr: 32'h1060_6000}, // Snooper
    '{idx: 32'd4, start_addr: 32'h1040_4000, end_addr: 32'h1040_5000},
    '{idx: 32'd3, start_addr: 32'h1040_3000, end_addr: 32'h1040_4000},
    '{idx: 32'd2, start_addr: 32'h1040_2000, end_addr: 32'h1040_3000},
    '{idx: 32'd1, start_addr: 32'h1040_1000, end_addr: 32'h1040_2000},
    '{idx: 32'd0, start_addr: 32'h1040_0000, end_addr: 32'h1040_1000}
  };

  axi_lite_xbar #(
     .Cfg                   ( FromHostTlbCfgXbarCfg          ),
     .aw_chan_t             ( ariane_axi_soc::aw_chan_lite_t ),
     .w_chan_t              ( ariane_axi_soc::w_chan_lite_t  ),
     .b_chan_t              ( ariane_axi_soc::b_chan_lite_t  ),
     .ar_chan_t             ( ariane_axi_soc::ar_chan_lite_t ),
     .r_chan_t              ( ariane_axi_soc::r_chan_lite_t  ),
     .axi_req_t             ( ariane_axi_soc::req_lite_t     ),
     .axi_resp_t            ( ariane_axi_soc::resp_lite_t    ),
     .rule_t                ( tlb_cfg_xbar_rule_t            )
   ) i_axi_lite_xbar         (
     .clk_i                 ( clk_i                                               ),
     .rst_ni                ( rst_ni                                              ),
     .test_i                ( 1'b0                                                ),
     .slv_ports_req_i       ( {cluster_lite_req , host_lite_req }                 ),
     .slv_ports_resp_o      ( {cluster_lite_resp, host_lite_resp}                 ),
     .mst_ports_req_o       ( { axi_lite_snoop_req_o, axi_lite_mbox_req,
                                c2hmailbox_lite_req,  h2cmailbox_lite_req,
                                llc_cfg_req,  c2h_tlb_cfg_req              }      ),
     .mst_ports_resp_i      ( { axi_lite_snoop_rsp_i, axi_lite_mbox_rsp,
                                c2hmailbox_lite_resp, h2cmailbox_lite_resp,
                                llc_cfg_resp, c2h_tlb_cfg_resp             }      ),
     .addr_map_i            ( FromHostTlbCfgXbarAddrMap                           ),
     .en_default_mst_port_i ( {1'b0, 1'b0}                                        ),
     .default_mst_port_i    ( '0                                                  )
   );

`endif

  axi_lite_mailbox #(
     .MailboxDepth ( 32'd8                       ),
     .IrqEdgeTrig  ( 1'b0                        ),
     .IrqActHigh   ( 1'b1                        ),
     .AxiAddrWidth ( 32'd32                      ),
     .AxiDataWidth ( 32'd32                      ),
     .req_lite_t   ( ariane_axi_soc::req_lite_t  ),
     .resp_lite_t  ( ariane_axi_soc::resp_lite_t )
     ) pulpmailbox (
       .clk_i       ( clk_i                                         ),
       .rst_ni      ( rst_ni                                        ),
       .test_i      ( 1'b0                                          ),
       .slv_reqs_i  ( { c2hmailbox_lite_req, h2cmailbox_lite_req  } ),
       .slv_resps_o ( { c2hmailbox_lite_resp,h2cmailbox_lite_resp } ),
       .irq_o       ( { s_c2h_irq, h2c_irq_o }                      ),
       .base_addr_i ( { 32'h1040_3000, 32'h1040_2000 }              )
       );

  axi_lite_scmi_mailbox #(
       .axi_lite_req_t(ariane_axi_soc::req_lite_t ),
       .axi_lite_resp_t(ariane_axi_soc::resp_lite_t )
  ) i_scmi_ot_mailbox (
       .clk_i,
       .rst_ni,
       .axi_lite_mbox_req,
       .axi_lite_mbox_rsp,
       .doorbell_irq_o,
       .completion_irq_o
  );


  sync_wedge i_host_mailbox_irq_sync (
              .clk_i    ( clk_i     ),
              .rst_ni   ( rst_ni    ),
              .en_i     ( 1'b1      ),
              .serial_i ( s_c2h_irq ),
              .r_edge_o ( c2h_irq_o ),
              .f_edge_o (           ),
              .serial_o (           )
              );

  initial assert (AXI_LITE_ADDR_WIDTH == 32)
    else $fatal(1, "Change `tlb_cfg_xbar_rule_t` for address width other than 32 bit!");


  // Quick $monitor (prints on any change)
// initial begin
//   $display("== AXI-Lite quick monitors ==");
// end

// initial begin
//   $monitor("TIME=%0t PERFC addr=0x%08h wdata=0x%08h req.b_ready=%b | resp.b_valid=%b resp.b=%0d",
//            $time,
//            events_cfg_perfc_req.aw.addr,
//            events_cfg_perfc_req.w.data,
//            events_cfg_perfc_req.b_ready,
//            events_cfg_perfc_resp.b_valid,
//            events_cfg_perfc_resp.b);
// end

// initial begin
//   $monitor("TIME=%0t  APMU addr=0x%08h wdata=0x%08h req.b_ready=%b | resp.b_valid=%b resp.b=%0d",
//            $time,
//            apmu_cfg_req.aw.addr,
//            apmu_cfg_req.w.data,
//            apmu_cfg_req.b_ready,
//            apmu_cfg_resp.b_valid,
//            apmu_cfg_resp.b);
// end

// always_ff @(posedge clk_i) begin
//   if (!rst_ni) begin
//     // nothing
//   end else begin
//     if (events_cfg_perfc_req.aw_valid || events_cfg_perfc_req.w_valid || events_cfg_perfc_resp.b_valid) begin
//       $display("TIME=%0t SUBSYS MST events_cfg_perfc: AWV=%b AWADDR=0x%08h AWREADY=%b | WV=%b WDATA=0x%08h WREADY=%b | BV=%b BREADY=%b B_RESP=%0d",
//                $time,
//                events_cfg_perfc_req.aw_valid,
//                events_cfg_perfc_req.aw.addr,
//                events_cfg_perfc_resp.aw_ready,
//                events_cfg_perfc_req.w_valid,
//                events_cfg_perfc_req.w.data,
//                events_cfg_perfc_resp.w_ready,
//                events_cfg_perfc_resp.b_valid,
//                events_cfg_perfc_req.b_ready,
//                events_cfg_perfc_resp.b.resp);
//     end
//   end
// end



endmodule
