Rodolfo-Pellizzoni-Lab/he-soc/hardware/ip_list/cva6/core/cache_subsystem/wt_cache_subsystem.sv

// Copyright 2018 ETH Zurich and University of Bologna.
// Copyright and related rights are licensed under the Solderpad Hardware
// License, Version 0.51 (the "License"); you may not use this file except in
// compliance with the License.  You may obtain a copy of the License at
// http://solderpad.org/licenses/SHL-0.51. Unless required by applicable law
// or agreed to in writing, software, hardware and materials distributed under
// this License is distributed on an "AS IS" BASIS, WITHOUT WARRANTIES OR
// CONDITIONS OF ANY KIND, either express or implied. See the License for the
// specific language governing permissions and limitations under the License.
//
// Author: Michael Schaffner <schaffner@iis.ee.ethz.ch>, ETH Zurich
// Date: 15.08.2018
// Description: Ariane cache subsystem that is compatible with the OpenPiton
//              coherent memory system.
//
//              Define PITON_ARIANE if you want to use this cache.
//              Define DCACHE_TYPE if you want to use this cache
//              with a standard 64 bit AXI interface instead of the OpenPiton
//              L1.5 interface.


module wt_cache_subsystem import ariane_pkg::*; import wt_cache_pkg::*; #(
  parameter ariane_pkg::ariane_cfg_t ArianeCfg       = ariane_pkg::ArianeDefaultConfig,  // contains cacheable regions
  parameter int unsigned NumPorts     = 3,
  parameter int unsigned AxiAddrWidth = 0,
  parameter int unsigned AxiDataWidth = 0,
  parameter int unsigned AxiIdWidth   = 0,
  parameter type axi_req_t = ariane_axi::req_t,
  parameter type axi_rsp_t = ariane_axi::resp_t
) (
  input  logic                           clk_i,
  input  logic                           rst_ni,
  output logic                           busy_o,
  input  logic                           stall_i,                // stall new memory requests
  input  logic                           init_ni,
  // I$
  input  logic                           icache_en_i,            // enable icache (or bypass e.g: in debug mode)
  input  logic                           icache_flush_i,         // flush the icache, flush and kill have to be asserted together
  output logic                           icache_miss_o,          // to performance counter
  // address translation requests
  input  icache_areq_i_t                 icache_areq_i,          // to/from frontend
  output icache_areq_o_t                 icache_areq_o,
  // data requests
  input  icache_dreq_i_t                 icache_dreq_i,          // to/from frontend
  output icache_dreq_o_t                 icache_dreq_o,
  // D$
  // Cache management
  input  logic                           dcache_enable_i,        // from CSR
  input  logic                           dcache_flush_i,         // high until acknowledged
  output logic                           dcache_flush_ack_o,     // send a single cycle acknowledge signal when the cache is flushed
  output logic                           dcache_miss_o,          // we missed on a ld/st
  // For Performance Counter
  output logic [NumPorts-1:0][DCACHE_SET_ASSOC-1:0]    miss_vld_bits_o,
  // AMO interface
  input amo_req_t                        dcache_amo_req_i,
  output amo_resp_t                      dcache_amo_resp_o,
  // Request ports
  input  dcache_req_i_t   [2:0]          dcache_req_ports_i,     // to/from LSU
  output dcache_req_o_t   [2:0]          dcache_req_ports_o,     // to/from LSU
  // writebuffer status
  output logic                           wbuffer_empty_o,
  output logic                           wbuffer_not_ni_o,
`ifdef PITON_ARIANE
  // L15 (memory side)
  output l15_req_t                       l15_req_o,
  input  l15_rtrn_t                      l15_rtrn_i
`else
  // memory side
  output axi_req_t                       axi_req_o,
  input  axi_rsp_t                       axi_resp_i
`endif
  // TODO: interrupt interface
);

  logic icache_adapter_data_req, adapter_icache_data_ack, adapter_icache_rtrn_vld;
  wt_cache_pkg::icache_req_t  icache_adapter;
  wt_cache_pkg::icache_rtrn_t adapter_icache;


  logic dcache_adapter_data_req, adapter_dcache_data_ack, adapter_dcache_rtrn_vld;
  wt_cache_pkg::dcache_req_t  dcache_adapter;
  wt_cache_pkg::dcache_rtrn_t adapter_dcache;

  logic                       icache_busy;
  logic                       dcache_busy;

  assign busy_o = dcache_busy | icache_busy;

  cva6_icache #(
    // use ID 0 for icache reads
    .RdTxId             ( 0             ),
    .ArianeCfg          ( ArianeCfg     )
  ) i_cva6_icache (
    .clk_i              ( clk_i                   ),
    .rst_ni             ( rst_ni                  ),
    .flush_i            ( icache_flush_i          ),
    .en_i               ( icache_en_i             ),
    .miss_o             ( icache_miss_o           ),
    .busy_o             ( icache_busy             ),
    .stall_i            ( stall_i                 ),
    .init_ni            ( init_ni                 ),
    .areq_i             ( icache_areq_i           ),
    .areq_o             ( icache_areq_o           ),
    .dreq_i             ( icache_dreq_i           ),
    .dreq_o             ( icache_dreq_o           ),
    .mem_rtrn_vld_i     ( adapter_icache_rtrn_vld ),
    .mem_rtrn_i         ( adapter_icache          ),
    .mem_data_req_o     ( icache_adapter_data_req ),
    .mem_data_ack_i     ( adapter_icache_data_ack ),
    .mem_data_o         ( icache_adapter          )
  );


  // Note:
  // Ports 0/1 for PTW and LD unit are read only.
  // they have equal prio and are RR arbited
  // Port 2 is write only and goes into the merging write buffer
  wt_dcache #(
    .AxiDataWidth    ( AxiDataWidth  ),
    // use ID 1 for dcache reads and amos. note that the writebuffer
    // uses all IDs up to DCACHE_MAX_TX-1 for write transactions.
    .RdAmoTxId       ( 1             ),
    .ArianeCfg       ( ArianeCfg     )
  ) i_wt_dcache (
    .clk_i           ( clk_i                   ),
    .rst_ni          ( rst_ni                  ),
    .enable_i        ( dcache_enable_i         ),
    .busy_o          ( dcache_busy             ),
    .stall_i         ( stall_i                 ),
    .init_ni         ( init_ni                 ),
    .flush_i         ( dcache_flush_i          ),
    .flush_ack_o     ( dcache_flush_ack_o      ),
    .miss_o          ( dcache_miss_o           ),
    .wbuffer_empty_o ( wbuffer_empty_o         ),
    .wbuffer_not_ni_o ( wbuffer_not_ni_o       ),
    .amo_req_i       ( dcache_amo_req_i        ),
    .amo_resp_o      ( dcache_amo_resp_o       ),
    .req_ports_i     ( dcache_req_ports_i      ),
    .req_ports_o     ( dcache_req_ports_o      ),
    .miss_vld_bits_o ( miss_vld_bits_o         ),
    .mem_rtrn_vld_i  ( adapter_dcache_rtrn_vld ),
    .mem_rtrn_i      ( adapter_dcache          ),
    .mem_data_req_o  ( dcache_adapter_data_req ),
    .mem_data_ack_i  ( adapter_dcache_data_ack ),
    .mem_data_o      ( dcache_adapter          )
  );


///////////////////////////////////////////////////////
// memory plumbing, either use 64bit AXI port or native
// L15 cache interface (derived from OpenSPARC CCX).
///////////////////////////////////////////////////////

`ifdef PITON_ARIANE
  wt_l15_adapter #(
    .SwapEndianess   ( ArianeCfg.SwapEndianess )
  ) i_adapter (
    .clk_i              ( clk_i                   ),
    .rst_ni             ( rst_ni                  ),
    .icache_data_req_i  ( icache_adapter_data_req ),
    .icache_data_ack_o  ( adapter_icache_data_ack ),
    .icache_data_i      ( icache_adapter          ),
    .icache_rtrn_vld_o  ( adapter_icache_rtrn_vld ),
    .icache_rtrn_o      ( adapter_icache          ),
    .dcache_data_req_i  ( dcache_adapter_data_req ),
    .dcache_data_ack_o  ( adapter_dcache_data_ack ),
    .dcache_data_i      ( dcache_adapter          ),
    .dcache_rtrn_vld_o  ( adapter_dcache_rtrn_vld ),
    .dcache_rtrn_o      ( adapter_dcache          ),
    .l15_req_o          ( l15_req_o               ),
    .l15_rtrn_i         ( l15_rtrn_i              )
  );
`else
  wt_axi_adapter #(
    .AxiAddrWidth       ( AxiAddrWidth ),
    .AxiDataWidth       ( AxiDataWidth ),
    .AxiIdWidth         ( AxiIdWidth ),
    .axi_req_t          ( axi_req_t ),
    .axi_rsp_t          ( axi_rsp_t )
  ) i_adapter (
    .clk_i              ( clk_i                   ),
    .rst_ni             ( rst_ni                  ),
    .icache_data_req_i  ( icache_adapter_data_req ),
    .icache_data_ack_o  ( adapter_icache_data_ack ),
    .icache_data_i      ( icache_adapter          ),
    .icache_rtrn_vld_o  ( adapter_icache_rtrn_vld ),
    .icache_rtrn_o      ( adapter_icache          ),
    .dcache_data_req_i  ( dcache_adapter_data_req ),
    .dcache_data_ack_o  ( adapter_dcache_data_ack ),
    .dcache_data_i      ( dcache_adapter          ),
    .dcache_rtrn_vld_o  ( adapter_dcache_rtrn_vld ),
    .dcache_rtrn_o      ( adapter_dcache          ),
    .axi_req_o          ( axi_req_o               ),
    .axi_resp_i         ( axi_resp_i              )
  );
`endif

///////////////////////////////////////////////////////
// assertions
///////////////////////////////////////////////////////

//pragma translate_off
`ifndef VERILATOR
  a_invalid_instruction_fetch: assert property (
    @(posedge clk_i) disable iff (!rst_ni) icache_dreq_o.valid |-> (|icache_dreq_o.data) !== 1'hX)
  else $warning(1,"[l1 dcache] reading invalid instructions: vaddr=%08X, data=%08X",
    icache_dreq_o.vaddr, icache_dreq_o.data);

  for (genvar j=0; j<riscv::XLEN/8; j++) begin : gen_invalid_write_assertion
    a_invalid_write_data: assert property (
      @(posedge clk_i) disable iff (!rst_ni) dcache_req_ports_i[2].data_req |-> dcache_req_ports_i[2].data_be[j] |-> (|dcache_req_ports_i[2].data_wdata[j*8+:8] !== 1'hX))
    else $warning(1,"[l1 dcache] writing invalid data: paddr=%016X, be=%02X, data=%016X, databe=%016X",
      {dcache_req_ports_i[2].address_tag, dcache_req_ports_i[2].address_index}, dcache_req_ports_i[2].data_be, dcache_req_ports_i[2].data_wdata, dcache_req_ports_i[2].data_be & dcache_req_ports_i[2].data_wdata);
  end


  for (genvar j=0; j<2; j++) begin : gen_assertion
    a_invalid_read_data: assert property (
      @(posedge clk_i) disable iff (!rst_ni) dcache_req_ports_o[j].data_rvalid && ~dcache_req_ports_i[j].kill_req |-> (|dcache_req_ports_o[j].data_rdata) !== 1'hX)
    else $warning(1,"[l1 dcache] reading invalid data on port %01d: data=%016X",
      j, dcache_req_ports_o[j].data_rdata);
  end
`endif
//pragma translate_on


endmodule // wt_cache_subsystem
