Rodolfo-Pellizzoni-Lab/he-soc/(commit log)

2026-04-24 Fix CVA6-EVU PMU write path: AXI cache and APMU config
    Set slv_aw_cache_i/slv_ar_cache_i to 4'b0010 (CACHE_MODIFIABLE)
    in axi_lite_to_axi_pmu; previously 0 caused i_axi_to_axi_lite_host
    to stall B-channel responses, permanently blocking all PMU->EVU
    writes after the first transaction
    Resize APMU ISPM (512->1024 words) and DSPM (4096->32768 words)
    Remap MEMORY_BASE_ADDR to 0x10606000 (EVU perf-counter config
    space, length 0x100) instead of L2SPM
2026-04-24 Remove .gitignore files from vendored ip_list; add missing generated files
    Each of the 67 IP repos brought its own .gitignore which caused
    generated files (e.g. opentitan uart_reg_pkg.sv, uart_reg_top.sv)
    to be silently excluded from the vendor commit. Deleted all 147
    .gitignore files inside ip_list/ so git tracks every file needed
    for simulation.
2026-04-24 Fix uart gitignore rule blocking opentitan uart IP
    Root .gitignore 'uart' rule matched any path component named 'uart',
    silently excluding all of ip_list/opentitan/hw/ip/uart/ including
    uart_reg_pkg.sv and uart_reg_top.sv needed for simulation.
    Changed to 'hardware/uart' to only match the QuestaSim transcript file.
2026-04-24 Vendor tb/vips into repo; remove from gitignore
    Commits the 4 VIP models needed for simulation:
    - hyperram_model/s27ks0641.v
    - i2c_eeprom/24FC1025.v
    - spi_flash/s25fs256s.v
    - camera/cam_vip.sv
    Previously cloners had to copy these manually from a shared path.
2026-04-26 Add pmu_cntr_test: 4-core PMU event counter benchmark
    Boots all 4 CVA6 cores (cores 2/3 via PMU overflow IRQ wakeup),
    runs each core through a distinct 64 KB L3 region, and measures
    LLC/MEM read+write traffic per-core and aggregate using APMU
    counters 2-19.
    Key implementation notes:
    - No Ibex boot; core 0 writes PMU regs directly over AXI
    - AMO spinlock (L3 cacheable) for serialised UART output
    - Source IDs for LLC->MEM SPU are 0-3 (CVA6 at crossbar slave[0])
    - Counter register bits [31:30] are Pending/Overflow; actual count
    is val & 0x3FFFFFFF
2026-05-07 Vendor hardware/deps submodules; hardcode UART to 38400 baud
    Convert all hardware/deps submodules (apb_uart, apb_node, apb_timer,
    axi_slice) from git submodule pointers to vendored plain files, consistent
    with the standalone-branch philosophy: clone + checkout + source uw_setup.sh
    is sufficient, no make init or external network access required.
    apb_uart change: hardcode iDLL = 0x20 in src/apb_uart.vhd to fix UART
    baud rate at 38400 @ 20 MHz SoC clock (divisor = 20_000_000 / 38400 >> 4
    = 32). Also fix iDLM reset placement to sit correctly inside the iRST
    branch rather than as an always-active override outside the if/elsif.
2026-05-28 sw: add pmu_evu_simple_sim — single-core CVA6-EVU PC milestone sim testReference test confirming cva6_synth_wrap field-flip mapping: writeEID=0x17 to EVENTID2 (addr+8) to generate e_id=2, matched by 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
2026-05-28 sw: add pmu_evu_bench — CVA6-EVU multi-event benchmark with Ibex firmware
2026-05-28 sw: add pmu_evu_c1_track — Core 1 PC milestone tracking via CVA6-EVUCore 0 programs Core 1's EVU with four probe addresses and configuresfour APMU counters to detect each milestone independently. PC 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
2026-05-28 sw: add c1_v2 — Core 1 PC tracking with DONE flag and 5-iteration validation
2026-07-11 fpga: archive gen_alsaqr.sh + document MIG bitstream flow in README
2026-07-23 apmu, spu, ibex_pmu: add Solderpad license headers to our sources
2026-07-24 artifact prep: Solderpad LICENSE (apmu, spu), STATUS/REQUIREMENTS/INSTALL, README showcase reframe + platform figure
2026-07-24 docs(REQUIREMENTS): scope 8.3.0 as the sim toolchain; note GCC 15.1.0 board toolchain (apmu-software)
2026-07-24 cva6: add Solderpad license header to perf_counters_evu.sv (was missing in the he-soc copy)
2026-07-25 axi_llc: document Waterloo modifications (PLRU replacement + AXI-ID cache partitioning) + Solderpad header on axi_llc_plru.sv
2026-07-25 docs: add EMSOFT supplementary material (design spec) + link it from the README
2026-09-11 Port the SoC RTL simulation to Vivado xsim
    Run the full AlSaqr SoC simulation on Vivado xsim (verified with 2024.2)
    instead of Questa. hello_culsans (2 cores, L2 flow) and quad_boot
    (4 cores, L3 flow, APMU wake-up) both reach [JTAG] SUCCESS at ~1.8 GB RSS.
    hardware/xsim/ holds the flow: build.sh turns the bender vsim file list
    into per-block xvlog/xvhdl calls and builds the DPI library, run.sh
    elaborates and runs a test for the l2 or l3 flow with a stall watchdog,
    chain_dbg.sh and tools/comb_fix.py locate and rewrite combinational
    rings. README.md documents what is simulated and every source change.
    Source changes:
    - always_comb blocks on ready/valid rings (LLC hit/miss + tag store,
    CVA6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
2026-09-16 Fix miss_handler latch from the xsim rewrite; VCU118 flow at 50 MHz
    The xsim-port rewrite of the "pack bypass ports" block in miss_handler.sv
    left `bypass_ports_req = bpr;` inside the innermost else, so the port array
    was only assigned for a non-shareable read on the AMO port. Synthesis
    inferred 35 latches; atomics, SC and LR to shareable DRAM reached the
    bypass arbiter only through a data-vs-enable race on the FPGA (won at
    20 MHz, lost at 50 MHz for DRAM targets) and never in xsim (the "AMO hang").
    Assign the array unconditionally at the end of the block.
    FPGA flow (VCU118, 4 cores, DDR4) moved to 50 MHz:
    - host AXI xbar and CCU LatencyMode CUT_ALL_PORTS (was NO_LATENCY)
    - apb_uart DLL 0x5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
2026-10-14 Accelerator socket in the cluster window; SoC validation tests
    With EXCLUDE_CLUSTER, the cluster window (0x1000_0000) now holds an
    accelerator socket with 8 slots (64 KB registers, 64-bit memory port,
    shared interrupt on PLIC ID 9) instead of an error slave that sat on an
    undriven bus. Accelerators are registered in hardware/accel/slots.json
    (generated accel_slots.sv and Bender.yml block), with a template, a
    generic unit testbench and C tests in software/accel.
    software/soc_tests: self-checking tests for the memory paths, atomics,
    4-core coherence, interrupts and the socket (t_wfi is a repro of the
    wfi-loop interrupt hang, not part of the suite).
2026-10-15 cva6: Ssqosid srmcfg CSR and a QoS tag on every core request
    Implement the Ssqosid extension's srmcfg CSR (0x181, RCID and MCID, WARL, M/S access, illegal from U, virtual
    instruction from VS/VU) and attach {AT, MCID, RCID} to the AXI user field of every AR and AW the core issues; AT
    marks instruction fetches. The SoC user field (ariane_axi_soc) carries the CCU's source-port bits below the tag;
    cva6_synth_wrap moves the core's tag above them and the CCU keeps the requester's tag on the write-backs it issues.
    qos_monitor is a simulation-only scoreboard that checks the tags at a core port and at the LLC.
2026-10-15 axi_llc: CBQRI capacity controller, way partitioning by RCID
    A CBQRI capacity controller (axi_llc_cbqri_cc, registers at 0x1040_1800: cc_capabilities, cc_alloc_ctl with
    CONFIG_LIMIT / READ_LIMIT, cc_block_mask) holds one way mask per (RCID, AT). hit_miss allocates refills only in the
    ways of the requester's mask, so blocks of different RCIDs with disjoint masks cannot evict each other; hits are
    served from any way. Refills and evictions carry the tag of the request that caused them.
2026-10-15 QoS verification: socket probe, LLC scoreboards, t_qos / t_cbqri, board-like simulated DRAM
    The accelerator socket answers reads of 0x103F_0000 with the user field of that read (and of the last write to it),
    so software can see the tag a hart puts on the bus; t_socket's last-word check moves off that address. host_domain
    instantiates the qos_monitor scoreboards at the LLC's slave and memory ports (simulation only) and, in xsim, puts
    the simulated DRAM behind a clock-domain crossing and a random-stall delayer (XSIM_DRAM_IDEAL restores the ideal
    model) so that reordering and eviction timing resemble the board. t_qos covers the CSR and the tag at every
    observation point; t_cbqri the capacity co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
2026-10-15 xsim: SPU match logic without a zero-delay loop; chain_dbg parses a trailing STALL line
    With the jittery simulated DRAM the SPU's always_comb that read ptr_d[mmatch] while writing ptr_d looped in xsim.
    Compute the entry to compare against (mmatch_next) once, from ptr_q and the insertion in flight, and drive
    latency_o / addr_idx_o unconditionally (this also removes a synthesis latch). chain_dbg.sh takes the last REACHED
    line even when a STALL line follows it. README: the new comb-loop entry, the DRAM path, alsaqr-mcp needs rtl_recompile.
2026-10-15 ibex_pmu: abort blocked WFP and WFO on host stall
    Failure
    -------
    The host stops the APMU PE through stall_pmu_i, which the Ibex controller
    only takes in DECODE when the ID stage is not stalled. cnt.wfp/cnt.wfo is a
    multi-cycle counter operation that keeps the ID stall (stall_pmc) asserted
    until a watched counter fires, and the counter-interface FSM stays in
    FSM_WFX. A stall requested while the PE waits is therefore never taken:
    the status register reads "stalled" but the core keeps waiting, and a wait
    whose mask never fires (for example mask 0) can only be recovered by a
    bitstream reload.
    Reproduction
    ------------
    Load a PE program that executes cnt.wfp on a counter with no events (or
    on m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
2026-10-15 apmu: grant ISPM fetches only when issued
    pmu_ispm asserts pmc_instr_gnt_o by default and again in the cycle a PE
    read completes (rvalid), without starting a read for the address the core
    presents in that cycle. Ibex takes that grant as acceptance of its next
    fetch, so fetch responses no longer line up with requests: with continuous
    fetching the core gets the word at +8 for the request at +4. On the board
    this shows up as the "first instruction is discarded" quirk that every PE
    image works around by linking code at the ISPM load address minus 4. A
    host write to ISPM interleaved with fetches could also desynchronise or
    wedge the fetch stream.
    In simu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
2026-10-15 apmu: correct KEEP_MIN comparison
    pmu_counter's KEEP_MIN operation replaced the counter when the event-info
    value was *greater* than the counter (`event_info_isol_q > counter_i`),
    which is KEEP_MAX's condition. A KEEP_MIN counter therefore tracked the
    maximum, and one preset to a large value (the usual way to start a
    minimum) never changed at all.
    Simulation (Vivado xsim, he-soc xsim-port, hello_culsans with
    -DCOUNTER_OPS_TEST): counters on DRAM read responses (event select
    0x9F003F, event info = latency, bits 15:0), the APMU PE stalled, 4096
    uncached DRAM reads from core 0:
    - KEEP_MAX: 8
    - KEEP_MIN, preset to 0x3FFFFFFF: stays 0x3FFFFFFF (expected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
2026-10-15 qos_monitor: check the LLC's output requests one cycle after sampling them
    The LLC's bypass demux and mux have no spill registers, so a bypassed request is at the memory port in the cycle
    it enters the LLC, and the output scoreboard could run before the input one had recorded it: a false "no recent
    LLC request with this user field" on every read of DRAM outside the LLC window. The llc_out role now queues what
    it samples and checks it on the next clock.
2026-10-15 xsim: unit testbench of the DRAM timing model; README on new files and changed packages
    tb_axi_dram_timing drives line reads and writes through the model against a fixed-delay memory and checks the
    cycle of every beat and response (wire, latency, bandwidth pacing and bus occupancy, late data, write response).
    README: a new file needs build.sh -j, and a changed package needs every importer recompiled, otherwise xelab
    dies with SIGSEGV instead of an error.
2026-10-16 soc_tests: t_dma, the accelerator socket's DMA vs the cores' caches
    A self-checking test that drives slot 0 of the accelerator socket (the
    example engine) and measures what its DMA port and the CPU see of each
    other's memory: buffers in the uncached SRAM, a DRAM source still dirty in
    the write-back L1, a DRAM destination the core already caches, the fence.i
    recipe, and DRAM above the cacheable region. It prints whether the source
    and destination hazards came out coherent and the DMA cycles per word, so
    the same program reports the behaviour of the design it runs on.
2026-10-16 host: make the accelerator socket's DMA coherent via a CCU port
    The socket's AXI master used to enter the host crossbar after the
    coherence unit, so its traffic was invisible to the cores' write-back L1
    data caches: t_dma measured a device reading stale data a core held dirty,
    and a device write the core never saw (only fence.i, a whole-L1 writeback
    and invalidate, bridged it). Route that master into the coherence unit
    instead, as a fifth, non-caching port next to the four cores
    (cva6_synth_wrap): an AXI-to-ACE shim issues ReadOnce for reads and
    WriteUnique for writes in the inner shareable domain -- the transactions
    the cores already use for their own uncached accesses -- so a read takes a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
2026-10-16 software/linux: socket_dma, the socket's DMA from Linux user space
    A user-space driver for slot 0 of the accelerator socket that maps the
    registers (through /dev/mem or /dev/uio0), hands the engine physical
    buffers (the reserved DMA pool, or its own locked pages via
    /proc/self/pagemap), starts it and waits by polling or on the interrupt
    (a blocking read of /dev/uio0). It checks every word with no cache
    maintenance and prints one line per mode. This is the Linux counterpart of
    soc_tests/t_dma; the README lists the kernel options and device-tree nodes
    it needs (UIO, the shared-dma-pool, pagemap, and the DTB handed to OpenSBI
    in a1), which live in the alsaqr-software Linux tree.
2026-10-16 accel: README, the coherent DMA port measured on the VCU118
    Board numbers for the socket's CCU port: a 64-bit word costs 90-128 cycles
    on the VCU118 (45-87 in simulation; the DDR's latency sits inside each
    snoop round trip) against 15-28 through the crossbar path it replaced, and
    t_dma reports source and destination coherent on the bitstream with the
    port while the soc suite passes 9/9. Under Linux on that bitstream the
    socket_dma test passes all four modes (pool, the process's own cached
    pages, /dev/uio0, interrupt completion) with every word correct and no
    cache maintenance.
2026-10-16 software/linux: drop the socket_dma binary from the tree
    The static riscv64 binary is a build output of `make` in this directory
    (and `make install` places it in the Linux rootfs overlay); it was added by
    mistake with the sources. Ignore it.
2026-10-16 accel: QoS tags on the socket's DMA -- I/O on behalf of an RCID
    Work a hart hands to an accelerator left the CBQRI accounting: the socket's
    DMA carried tag 0. Two mechanisms, with the policy selectable:
    - the slot port contract gains reg_user_i (the requester's SoC user field:
    source port, RCID, MCID, AT, with every register strobe) and mem_user_o
    (the tag of each DMA request). The template, example and crc32 latch the
    requester's user field at START (TAG register, 0x28) and put it on every
    DMA request of that run, so the accelerator's traffic is charged to the
    hart that started the work, and software can read back which hart it was.
    - the socket is the trusted tagging point: per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
2026-10-16 t_dma: the DRAM timing model applies to the device's DMA
    The model sits on the memory side of the LLC, so a device's DRAM traffic
    pays it like a core's. Step 7 measures it: with LAT_RD = 256, DMA from DRAM
    outside the LLC's cached window goes from 75 to 320 cycles per word (every
    word a memory read; the model counts all 64) while an SRAM-to-SRAM copy
    stays at 63. dram_model.md says so.
2026-10-17 t_part: LLC way partitioning between the accelerator and the cores, measured
    A soc test that gives the LLC's 16 ways to three principals with CBQRI
    way masks and measures what each gets: an app core chasing a dependent
    chain through 8 lines of every set (RCID 1), a streaming core (RCID 2)
    and the slot-0 accelerator started under RCID 3, so its DMA carries that
    tag. Phases: each alone, everyone shared, and three partitions (all fit,
    app too small, accelerator too small), with the DRAM timing model off
    and on. After each window the aggressors stop and probes with the LLC
    read-miss counter count the lines each principal still holds.
    On the VCU118 (bitstream iotag) capacity follows the masks ex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
2026-10-17 Ethernet: the AMD AXI Ethernet subsystem and AXI DMA on the VCU118's 1G port
    The PULP ethernet is excluded (exclude-ethernet=1 xilinx-ethernet=1, macro
    XILINX_ETHERNET) and the host crossbar's Ethernet port takes the AMD AXI
    1G/2.5G Ethernet Subsystem (SGMII over LVDS to the board's DP83867) and an
    AXI DMA with scatter-gather: MAC registers at 0x3000_0000, DMA registers at
    0x3004_0000, the subsystem's interrupt on PLIC 3, DMA TX/RX completion on
    PLIC 11/15.
    The DMA's three masters are upsized, muxed and split into single beats, then
    muxed with the accelerator socket's DMA into the coherence unit's DMA port
    (ReadOnce/WriteUnique), so received frames and descriptors are coherent with
    the core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
2026-10-17 t_eth: the Ethernet subsystem from a core, frames looped back through the DMA
    software/eth/include/xeth.h is a polled driver: MDIO and the DP83867's
    extended registers (SGMIICTL, which the PHY needs before it outputs the 625
    MHz clock), descriptor rings in cached DRAM, MAC setup, link state, PCS/PMA
    loopback. t_eth brings the DMA and rings up, scans MDIO, sends frames of 14
    to 1514 bytes from cached buffers into cached buffers through the loopback
    (the stand-in's in xsim, the PCS/PMA's own on the board), fills the TX ring
    with a burst, checks the two DMA interrupts at the PLIC (clear the DMA status
    register, then claim and complete: a gateway keeps a source pending until it
    is claimed) and,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
2026-10-17 netboot: boot Linux over Ethernet instead of JTAG
    A loader linked at 0x8F00_0000 that brings the link up, gets an address with
    DHCP (or STATIC_IP=), finds its server with a UDP broadcast (ALSAQR-NETBOOT?
    on port 6969, fallback SERVER_IP=), fetches alsaqr.dtb to 0x8180_0000 and
    fw_payload.bin to 0x8000_0000 with TFTP (blksize 1428) and jumps into the
    payload with a0 = hart id and a1 = the DTB, as the JTAG flow does. It answers
    ARP and ping meanwhile. The server is alsaqr-mcp/scripts/netboot_server.py.
2026-10-18 t_eth on the VCU118: PASS 37 checks; the PCS/PMA found by its identifier after the PHY clock enable
    On the board the internal PCS/PMA answers on MDIO only once the DP83867 drives
    the 625 MHz SGMII clock (after SGMIICTL), at address 1 (and 0) with the Xilinx
    identifier 0x0174/0x0C00, not with zero IDs as the stand-in had it. The driver
    recognises it by that identifier, the test enables the PHY clock before it
    looks for the PCS and prints the MAC's status bits (RxDcmLock, MgtRdy,
    PhyRstCmplt) and a full MDIO scan, and the stand-in reports the same IDs and
    the ID register value the 7.2 IP reads (0x09000000). The loader waits for a
    cable indefinitely and retries DHCP instead of giving up.
    Board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
2026-10-18 xeth: the MAC speed codes were swapped; t_eth waits for the copper link and prints the MAC counters
    EMMC bits 31:30 encode 1 Gb/s as 10 (0x80000000) and 100 Mb/s as 01 (0x40000000); the driver had them the
    other way round, so on the board the MAC ran at 100 Mb/s on a 1 Gb/s SGMII link: every byte went out ten
    times (the PC counted 631-byte frames from the board and dropped them all) and nothing came in. The PCS
    loopback of t_eth did not notice, since both directions were wrong the same way. Round trips are faster
    now (1514 bytes: 22473 cycles, was 27981).
    t_eth on the board now waits up to 10 s for the copper link after the PHY reset (it comes up a few seconds
    later), listens 8 s, and print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
2026-10-18 netboot: boots Linux over the private link to the PC with all four harts
    The board is never on a wider network: a USB adapter of the PC is cabled to the VCU118, PC 10.42.0.1,
    board 10.42.0.2, so the loader is built with STATIC_IP/SERVER_IP (no DHCP server on that link).
    Fixes found with the cable in: the receive filter only passed the discovery port, so the TFTP server's
    reply (from a fresh port) was received and thrown away (tftp_port); the loader now retries discovery for
    ever, printing the MAC counters each round, prints an additive checksum of the payload and the DTB (the
    host compares with sum(bytes)), and uses the printf formats the small libc has.
    All four harts enter OpenSBI as wit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
2026-10-18 docs: Ethernet on the board: the link to the PC, the loader, the Linux device tree gotchas
2026-10-19 docs: Ethernet on the board with Linux 6.1: the PCS/PMA node, SSH, the measured rates
2026-10-19 netboot: widen the LLC cached range to all of RAM before Linux; docs: shrinking it on a running system wedges the SoC
    Out of reset the LLC caches only the first 8 MB (the kernel image). The loader now sets the end to 0xA000_0000
    (LLC_CACHED_END, make LLC_CACHED_END=0 keeps the ROM's) while nothing else runs. Found while chasing a Linux hang
    that looked like a read of the socket's QoS probe: t_iotag passes on the ethernet bitstream and the probe reads fine
    from Linux with any srmcfg; what wedges the SoC is shrinking the cached range at run time (dropped lines, dirty
    ones included, stay in the LLC while new accesses bypass it), reproduced even flushed and under stop_machine.
2026-10-22 fpga/qspi: set the board part, like the other IP scripts
    Under Vivado 2024.2 the IP Makefiles copy only the .xci (and the OOC .dcp)
    into ip/, because the IP's outputs are now in <ip>.gen, so the top-level
    project regenerates them. The QSPI IP was the only one customized without
    the board part, so the project, which sets the VCU118 board part, locked it
    ("IP board change") and its synthesis failed with "module 'xilinx_qspi' not
    found". The same change as 62c248c0 on es/opendram-16x-timing.
2026-10-22 cva6: enforce counter access gates and zero absent selectors
    Require the complete machine, hypervisor and supervisor enable chain for
    lower-privilege counter reads and distinguish illegal-instruction from
    virtual-instruction faults when access is denied. Make selectors for
    unimplemented counters read as zero with ignored writes, and exercise
    every enable combination in S, U, VS and VU modes plus the absent
    selector range in the architectural test.
2026-10-22 cva6: implement Sscofpmf filtering and overflow interrupts
    Extend HPM selectors with privilege-mode inhibit and sticky overflow
    controls, expose scountovf with counter-enable masking, and latch local
    counter-overflow interrupt 13 for machine or delegated supervisor
    handling and software acknowledgment. Resolve eligible interrupt
    destinations before source priority, preserve counter and selector write
    precedence, and publish combinational outputs once to avoid simulation
    delta-cycle loops; extend the RTL and architectural tests to cover
    filtering, overflow, rearming, delegation and interrupt delivery.
2026-10-23 fpga: time the axi_cdc-to-MIG AXI paths (no clock of its own on the MIG UI clock pin)
    constraints.xdc created a primary clock on u_ddr4_0/c0_ddr4_ui_clk and made it asynchronous to every other
    clock. That pin is the MIG's own mmcm_clkout0, the clock of the MIG's AXI slave, so the synchronous paths between
    the axi_cdc's MIG side and the MIG AXI front end (2842 + 732 endpoints) were never timed. Timed correctly, the
    routed OpenDRAM build od_eth_20261022_124152 failed them at the slow corner: MIG -> axi_cdc R FIFO -1.091 ns
    (86 endpoints), axi_cdc W -> MIG -0.224 ns (15). The MIG AXI front end and the axi_cdc had been placed in
    different SLRs.
    Remove the create_clock on the pin and the clock g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
2026-10-23 opendram/sim: OpenDRAM simulated with he-soc's MIG configuration
    he-soc's xsim flow uses a behavioural memory, so it never simulates
    OpenDRAM. sim/ holds a recipe instead: a patch for OpenDRAM's repository at
    663ea1e, the commit rtl/ is copied from. It generates the MIG the way he-soc
    does (one x16 at DDR4-1250, CL 9 / CWL 9, 64-bit AXI, ID 9, auto-precharge
    off), sets the JEDEC referee's limits for tCK 1600 ps, and sets the pin
    decoder's clock. Running OpenDRAM's make sim with it: TEST PASSED with
    every read compared, 0 JEDEC violations in 62,429 checks, and the first
    command 169 clocks after each REF (tRFC 163), seen by the referee and on
    the DDR4 pins.
2026-10-23 opendram: README: where it lives, how to build, simulation and board results
    The README now says that everything he-soc needs is in
    hardware/ip_list/opendram, and how to build with OPENDRAM=1. It notes that
    this branch's constraint change (08706a3d) applies to every build. The
    refresh timing is no longer called "not simulated": sim/ measured it. A
    new section records what ran on the VCU118 and on which commit. Linux 6.1
    needs alsaqr-software's vDSO fix (linux_patch_6.1) for SSH to stay up,
    with either memory controller.
2026-10-24 docs: the HPM series on the board, and why rdcycle stands still under Linux with the SBI PMU driver
2026-10-24 bootrom: park and wake any number of harts
    main.c had one wait/claim routine per hart (2 and 3 by name, everything else
    on hart 1's context), so a fifth hart would have polled hart 1's claim
    register forever. The dispatch is now generic: the S-mode PLIC context of
    hart h is 2h+1, its claim/complete register 0x0C200004 + 0x1000*(2h+1), its
    enable word 0 at 0x0C002000 + 0x80*(2h+1). Harts 0 and 1 still sleep until
    the mailbox interrupt (source 10) is their claim; hart h >= 2 sleeps once and
    completes source 156 + h - 2, the overflow of APMU counter h - 2, exactly what
    quad_boot and the soc_tests harness raise for harts 2 and 3 today and what
    they raise for harts 4 to 7 on an eight-core SoC.
    u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
2026-10-24 soc_tests: wake-up and t_smp for SOC_NUM_CORES cores
    soc_wake_all() raised the APMU overflow interrupts of counters 0 and 1 for
    harts 2 and 3 only. It now loops over harts 2 .. SOC_NUM_CORES-1: priority
    and S-mode enable of PLIC source 156+k on context 2h+1, then counter k
    armed to overflow at once. SOC_NUM_CORES defaults to 4; a build with
    -DSOC_NUM_CORES=8 (sw_build extra_cflags) matches a NUM_CVA6=8 SoC. t_smp
    takes its core count from it instead of a literal 4.
2026-10-24 xsim: do not compile the DMA IP libraries into the Vivado installation
    xilinx_ip.sh compiled the AXI DMA's VHDL libraries with `xvhdl -work <lib>`.
    Vivado's global xsim.ini maps every one of those names (axi_dma_v7_1_34,
    axi_datamover_v5_1_35, lib_pkg_v1_0_4, ...) to the precompiled copies under
    data/xsim/ip of the installation, which is writable here, so each build
    rewrote the installation, and two builds at once corrupted it ("failed to
    restore 'axi_datamover_v5_1_35.axi_datamover_ibttcc'" in both, no RTL
    compiled). The "up to date" check never fired either: it looked for
    $WORK/xsim.dir/axi_dma_v7_1_34, which that flow never creates.
    The script now lists a library the installation provide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
2026-10-24 soc_tests: the QoS user-word layout follows the core count
    ariane_axi_soc::QosUserLsb = $clog2(NumCVA6 + 1) is the width of the CCU
    source-port field at the bottom of the AXI user word, so the RCID starts at
    bit 3 with up to seven cores and at bit 4 with eight. t_qos (SRC_BITS 3) and
    t_iotag (ACCEL_USER with << 3 / << 7) had the four-core layout hard-coded
    and failed 12/35 and 9/27 checks on a NUM_CVA6=8 SoC while the hardware was
    right. soc_test.h now defines SOC_SRC_BITS from SOC_NUM_CORES, accel.h's
    ACCEL_USER uses the same width (ACCEL_NUM_CORES, taken from SOC_NUM_CORES,
    default 4), t_qos decodes the probe with it and runs its per-core work on
    all SOC_NUM_CORES cores instead of a litera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
2026-10-24 docs: cores.md, the core count, the PLIC and what fits the VCU118
    How to build n cores in every flow, what had to change for a fifth one, why
    the PLIC was the limit and what the tree finder costs, the routed numbers of
    the four-core and eight-core builds of this branch next to main, and what is
    verified in xsim at four and eight cores.
2026-10-25 soc_tests/t_stopm: bare-metal port of Linux's multi_cpu_stop; eight-core board findings
    t_stopm runs the kernel's stop_machine loop on every core of the build: a
    shared state word and an acknowledge counter in one 16-byte line, atomic
    decrements to acknowledge, the last acker writing the next state with plain
    stores, and (unless -DNO_SIDE_EFFECTS) the per-iteration store and atomic on
    the core's own line that touch_nmi_watchdog and rcu_momentary_dyntick_idle
    do. A core that spins too long counts a stall instead of hanging the test;
    -DVERBOSE prints each round; SOC_NUM_CORES selects the participants.
    On the eight-core VCU118 bitstream it passes with four cores and hangs with
    six to eight, wh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
2026-10-25 soc_tests/t_stopm, docs: the eight-core stop_machine hang is a store/ReadShared livelock in the L1
    t_stopm gets a stall report (shared words, per-core last acked state, decrement result, advances and a heartbeat
    in SRAM) and build knobs for simulation (SPIN_LIMIT, the default is now 1M iterations). On the eight-core board the
    report shows every decrement of a state completing with a distinct value while the last acker's plain store of
    the next state never becomes visible and that core's heartbeat freezes in the store.
    The eight-core xsim library reproduces it in round 0 and probing the cores' cache controllers and the CCU state
    machine shows the mechanism: the writer's store takes MAKE_UNIQ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
2026-10-25 docs: eight cores on the VCU118 with the L1 fix: Linux boots with 8 CPUs, bandwidth at 4 / 6 / 8 CPUs
    cores8_fix (799,632 LUTs, setup met): t_stopm 8 cores 200 rounds, t_smp/t_qos/t_iotag 8-core builds pass on the
    board; Linux 6.1.183 boots with eight CPUs three times out of three (shell after 111 s), six and four as before.
    Bandwidth sweeps with 1..n loaded harts on the same bitstream: DRAM streaming saturates at two to three harts
    (15.5 MB/s read with four CPUs online, 14.3 with six, 13.6 with eight: idle CPUs cost bandwidth), LLC-hit reads
    grow to 22.3 MB/s at eight harts but hart 0 takes half of it (CCU priority), LLC-hit writes top out near 20.
2026-10-25 soc_tests/t_bw: streaming cost of the coherent path in cycles per 16-byte line, 1 to N harts at once
    Every hart owns 256 lines of cached DRAM, flushes its L1 with fence.i before each window (a plain fence does
    not flush a coherent CVA6 data cache) and streams loads (ReadShared), stores (ReadUnique, then the write-backs
    of the next fence.i) or loads of hart 0's lines (snoop data from that L1) while 1, 2, 4, 8 harts take part;
    rdcycle around the window, aggregate and per-hart cycles per line printed by hart 0. Calibrates the CCU model
    of hardware/docs/ccu_model.md and measures its changes; builds with -DSOC_NUM_CORES=<n>.
2026-10-25 docs: ccu_model.md: where the coherent path's cycles go, a calibrated cycle model, and the decoupled CCU
    Cycle traces of the unchanged design (43 cycles per line: 2 to the state machine, 2 decode, 5 snoop round,
    1 issue, 24 memory of which 18 are the crossbar's spill registers and 6 the LLC, 2 back, 5 in the core), the
    35-cycle aggregate, the write-back path, the discrete-event model (ccu_model.py) that reproduces them and
    predicted the decoupled design within 7 %, the ranking of the remedies, the change, its three correctness
    fixes and the verification table.
2026-10-25 docs: ccu_model.md: eight-core t_bw numbers and latency under load with the decoupled CCU
    Eight harts: one 16-byte line per 8.5 cycles aggregate against 35 (model 9.0), reads and store misses alike;
    t_part's all-shared phase: the pointer-chasing app pays 10 % next to a streaming core and the accelerator's DMA
    instead of 3.5 times (5 with the DRAM model), the accelerator 17 % instead of 3.4 times. Verification table
    updated (regression paused for the bitstream builds, t_part reruns pending).
2026-10-26 soc_tests/t_part: latency-under-load expectations for the decoupled CCU; docs: verification complete
    The two checks that asserted the serialising coherence unit's penalty (an app hit behind a streaming core at
    least 30 % slower when shared, lines lost to sharing) now expect at most 30 % (measured 10 to 14 %) and no fewer
    lines lost than with partitioning; the capacity evidence stays in the Q, B1 and R phases. Both builds pass 202
    checks on the final state machine. ccu_model.md: eight-core regression 13 of 13, both t_part runs, the
    cores8_dec3 gate (805,846 LUTs, setup met at 50 MHz).
2026-10-26 docs, soc_tests/t_chk: the decoupled CCU loses single stores under concurrent load on the VCU118 (open, blocking)
    A verifying stress on the board (private buffers, address/round-tagged pattern, every word checked) finds stale
    8-byte words with 2 to 8 harts on the decoupled-CCU bitstreams and none on the serial-CCU one; LLC-resident
    buffers show it too; one hart is clean. Every stale word is the lower word of its 16-byte line, the one whose
    store missed and caused the refill. t_chk is the bare-metal twin of that stress for xsim (8-core run stalls the
    simulator, under trace). The eight-core bandwidth numbers stand, the change is not mergeable until this is fixed.
2026-10-26 soc_tests/t_chk: read-back, flush-refetch, traffic-only and shared-line modes; board regions at a fixed DRAM address
    CHK_MODE 1 reads every stored word back at once (a merge lost in the refill shows there), 2 flushes the L1 with
    fence.i after each batch and refetches it (a word lost in the write-back or returned stale by the LLC shows there,
    re-read after another flush to tell the two apart). CHK_TRAFFIC 1 / 2 make the other cores load / store only.
    CHK_SHARED 1 adds one access to a 32 KB array shared by all cores per private line (one in eight a store), 2 loads
    only, 3 stores only: snoops then hit in the other cores' L1s, including lines a core is evicting for its own
    refill, which is what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
2026-10-26 docs: coherence.md: the refill / snoop-write race, its reproducer, fix and verification; cores.md, ccu_model.md: the open issue is fixed
    The decoupled CCU's lost stores were an L1 race the serial CCU never exposed: a snoop status write landing on a
    way the miss handler refilled since the snoop's lookup. coherence.md has the mechanism, why a clean shared victim
    is needed, why private-buffer tests are clean, the bare-metal reproducer numbers, the fix and the simulation and
    board verification tables (sim before/after, both regressions, t_part, the eight-core bitstream cores8_fix2_r1 with
    t_chk, Linux chk, the read-back stress that used to hang Linux, and the unchanged bandwidth sweep).
2026-10-26 docs: cores8_fix2_r1b is the reference eight-core bitstream: setup met everywhere, hold only in the known classes, board results identical to cores8_fix2_r1
2026-10-28 host: slowdown regulator and DRAM timing model after the LLC-memory SPU
    The memory path behind the LLC is now LLC -> SPU (APMU port 9) -> slowdown regulator -> DRAM timing model -> DRAM.
    The slowdown (ip_list/slowdown, from es/quad-evu-standalone/slowdown: latency 20, one request per throttle period,
    FIFO depth 8) is enabled by `define USE_SLOWDOWN in host_domain.sv; commented out, the SPU feeds the model directly.
    The SPU sees each request as the LLC issues it and each response after the slowdown's and the model's delays.
    Also the slowdown's tests (software/slowdown_qc, slowdown_bw, slowdown_st) and its unit test.
    (cherry picked from commit a7af3ec9e95026d68e83590501e74c20934ea587)
2026-10-28 host: per-core AXI-ID attribution for the 5-port CCU; CCU-source widths from the package; SPU source from user
    Since a0dd722c (the socket DMA as the CCU's 5th port, 10-bit CCU IDs) cva6_axi_id_remap took the core number from
    bit positions of the 4-port CCU's 9-bit ID: every shareable request looked like core 2, write-backs split by core
    parity, the DMA like core 3, for the APMU's port-9 SPU and the LLC's per-ID way masks. The remapper now copies the
    source port the CCU writes into user[QosUserLsb-1:0]; only its low bits fit in the 4-bit ID.
    - ariane_soc_pkg: NumCcuDmaPorts / NumCcuPorts / CcuSrcWidth, the remapper's slots, the memory-port source codes;
    QosUserLsb, the CCU config, the rema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
2026-10-28 software: quad-core fixes from the audit (console, APMU benches, runtime, wake-up, self-checking tests)
    The reviewed fix set of the quad-core audit (made on es/main-slowdown), applied onto the 8-core main with a 3-way
    merge:
    - Board builds of slowdown_qc, slowdown_st and quad_boot no longer reprogram the UART: divisor 651 left DLM = 2 next
    to the hard-wired DLL, i.e. a ~5.3 kBd console.
    - One APMU address map in software/quad_boot/pmu_defines.h, which every APMU bench now includes. The DSPM is at
    0x1042_9000 since 05eee786, but every in-tree APMU-firmware bench, firmware linker script and loader still used
    0x1042_8000, where the Ibex's first data access is never granted. Loaders copy i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
2026-10-28 axi_burst_splitter: align the addresses of split INCR beats
    The vendored PULP axi_burst_splitter stepped every split beat of an INCR burst by 1 << size from the previous
    address. A burst that starts unaligned then gave unaligned single beats after the first, whose low strobe lanes
    lie below their address, and a strict slave drops those bytes. The Xilinx AXI DMA's RX descriptor update (status
    and app0-4 from descriptor + 0x1C) went out at 0x5c, 0x64, 0x6c, 0x74 instead of 0x5c, 0x60, 0x68, 0x70, and
    the xsim memory never wrote app4 (the received length) for descriptors in DRAM outside the LLC window; the LLC
    places beats by line offset and strobe, which hid it everywhere else. Step from the a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
2026-10-28 host: the Xilinx Ethernet DMA on its own CCU port (accelerator socket N, Ethernet N+1)
    NumCcuDmaPorts = 2: the CCU's DMA ports are the accelerator socket's (CcuAccelPort = NumCVA6) and the Ethernet
    DMA's (CcuEthPort = NumCVA6+1), instead of one port shared through a 2:1 mux. The CCU writes the port into
    user[CcuSrcWidth-1:0], so the LLC-memory SPU reports accelerator traffic as source N and Ethernet as N+1; the
    other crossbar masters' codes move up by one. No width changes with 4 or 8 cores (CcuSrcWidth 3 / 4).
    - cva6_synth_wrap: the DMA ports' ACE conversion and snoop responder are generated per DMA port; the
    one-DMA-port assertion becomes checks that every CCU port is driven.
    - cva6_subs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
2026-10-28 host: an SPU in front of the accelerator socket (APMU port 2N+2); the socket arbiter holds a waiting request
    - axi_spu_top i_spu_accel on the socket's DMA master in cva6_subsystem: transparent, DRAM range only, source
    CcuAccelPort, CAM 8; APMU port 2N+2 (10 with four cores). ariane_soc gains the APMU port map (Apmu*Idx,
    ApmuNumPorts) and host_domain a time-0 check that the ports fit pmu_pkg::PORT_ID_BITS (an eight-core build
    stops there until the APMU fields are widened).
    - accel_socket: the slot arbiter re-picked every cycle, so a waiting request's AR/AW payload could change before
    its grant (an AXI violation the SPU would count twice); the selection is now held until the grant, and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
2026-10-29 software: the runtime's memcpy and memset stay loops (the unaligned memset called itself)
    At -O3 GCC's loop distribution took the byte loops of common/syscalls.c's memcpy and memset for memcpy / memset
    idioms and replaced them with calls of those very functions: an unaligned memset (pointer or length not a
    multiple of 8) then called itself until the stack had overwritten memory. Every bare-metal program has it; the
    netboot loader's DHCP (a memset of 300 bytes at frame + 42) hung after "link up" and, left running, ended with
    harts that could not be halted. NO_LIBCALL (optimize("no-tree-loop-distribute-patterns")) keeps both functions
    loops, in common/syscalls.c and in the loader's copy; nothi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
2026-10-29 soc_tests/t_storm: every master at once, every APMU event source counting it
    All N cores, the accelerator socket's two slots and the Ethernet DMA make DRAM traffic in one window, while one APMU
    counter each counts every core's EVU (D$ or I$ refills), every core's SPU, the socket's SPU and the LLC memory port's
    SPU by source (each core, the socket, the Ethernet, plus the debug module and the APMU, which must stay idle, and all
    of them together). The APMU's PE (pe_fw.S, rv32, copied into the ISPM) arms the EVUs, reads every register back, and
    samples all counters during the window and once after it. A round counts one SPU event (read or write requests or
    responses), with the DRAM timing model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
2026-10-29 soc_tests/t_wfi: the timer is armed after the print; where CVA6 takes the wfi's interrupt
    mtime runs at RTC/2: ~61 us per tick in sim, 40 ns on the FPGA (25 MHz). The first version armed mtimecmp =
    mtime + 2 before its "sleeping" print, so on the FPGA the interrupt was taken before the wfi, the handler disarmed
    the timer, and the wfi slept for ever (the board's no_result at 4 and 8 cores). The timer is now armed right before
    the wfi, DT ticks ahead (2 in sim, 2500 = 100 us on the FPGA).
    The test now reports where the interrupt was taken. CVA6 runs the instructions already decoded behind a wfi before
    it takes the interrupt that woke it (the privileged spec: mepc = wfi + 4; the wfi does not f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
2026-10-30 accel: the socket takes every R and B as it comes (a response it refused could hang the SoC)
    axi_from_mem (axi_lite_from_mem + axi_lite_to_axi) is ready only for the R or the B of its oldest open request, but
    AXI orders responses within a channel only, and the coherence unit does answer out of request order: its state
    machine can take a later AR before an earlier AW, a write to a line with a read in flight (a core's refill, say)
    waits for that read, and a read waits for an older read of its ID while a write does not. A response the socket
    refused stayed on the CCU's response path, which all its ports share and its state machine waits on, so when the
    response the socket was waiting for needed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
2026-10-30 accel: every AR, AW and W carries its own request's tag (writes went out with the previous write's tag)
    The socket stamps each slot's DMA with its QoS tag (the AXI user field; axi_from_mem has none). It carried the tags in
    three per-channel fifo_v3s, pushed at the grant and popped at each channel's handshake. But axi_from_mem grants a
    write only once both its AW and its W have been taken, and the spill registers in front of the CCU take each when
    they have room: with several writes open, the AW (or the W) of a write is taken before its grant, pops the empty FIFO
    (the pop is ignored), and its own tag, pushed at the grant, stays behind for the next write. From then on every write
    carried the t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
2026-10-30 soc_tests/t_part: partitioned may be up to 3 % slower than shared for the app (the two differ by jitter only)
    The P-against-S latency check held the app's cycles per hop in P (8 ways of its own) to at most those in S (all 16
    ways shared) with no margin. With the decoupled coherence unit the app keeps all its lines in S as well (0 lost after
    either window), so the two differ by the jitter of the streamer's and the accelerator's traffic only, and between
    builds in simulation each of them moved by up to 1.5 cycles per hop: P 1 to 6 % faster than S in every earlier run,
    but on b47dd89f (4 cores, model-on pass) S 50.31 and P 50.35, and the test failed 1 of 204 checks on that alone. The
    check now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
2026-10-30 axi_llc: the channel splitter and its burst cutter assign their outputs once (xsim stalled t_qos at 8 cores)
    t_qos with 8 cores stopped at 4.26 ms simulated in xsim, while the simulator's memory grew by ~300 MB/s (40 GB before
    alsaqr-mcp's watchdog killed it), on every build since the test's current program (the older program passed): one of
    the combinational "rings" of hardware/xsim/README.md, section 2. A ptrace of the stalled cycle (--debug typical
    snapshot) ranks 11.5 million executions each of the AW channel splitter's control block, its burst cutter, the
    descriptor arbiter i_rw_arb_tree and axi_llc_top's event assignment, against under 100 000 for anything else. The
    splitter's proc_con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
2026-10-30 qos_monitor: the per-tag count lines print each tag's RCID, MCID and AT (xsim printed 0 for every tag)
    At the end of a run each llc_in / llc_out instance prints one "[QOS] <name> src=.. at=.. rcid=.. mcid=.. ar=.. aw=.."
    line per user value it saw. Under xsim every one of them showed at=0 rcid=0 mcid=0 (t_qos tags with RCID 5.. and MCID
    9.., t_storm with 14 and 15), so tags differing only there printed as several identical-looking lines. The cause is an
    xsim 2024.2 defect, reproduced in a 20-line test: in one statement with several function calls that take a foreach
    index, every call after the first returns 0 (f_src(u) was right, f_at / f_rcid / f_mcid were not); one call per
    statement, or t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
2026-10-31 pmu_evu_bench, pmu_evu_simple_sim: the board's UART is left as the startup code set it
    With fpga=1 both benches set the divisor for 9600 Bd at 100 MHz (651). On the FPGA the UART's DLL is hard-wired, so
    651 only sets DLM and the console came out as garbage at 50 MHz (pmu_evu_bench on the board, 2026-10-28). Like
    slowdown_qc, slowdown_st and quad_boot, they now set the UART only in simulation.
    The simulation builds are unchanged: the same PT_LOAD bytes at 4 and 8 cores (two-pass, as the sims build them).
    On the VCU118 with the 8-core bitstream of 4531ce90 both print their tables and "Test complete." with the sim's
    event counts (pmu_evu_simple_sim: L1D misses 511, LLC_RD 514, MEM_RD 512, 37 i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
2026-10-31 pmu_test, pmu_test2, pmu_perfc_test, pmu_L3_test_v2: the board's UART is left as the startup code set it
    As in 24cc0eeb for pmu_evu_bench and pmu_evu_simple_sim: with fpga=1 these benches set the divisor for 9600 Bd at
    100 MHz (651), which on the FPGA (DLL hard-wired) only sets DLM and garbles the console at 50 MHz. They now set the
    UART only in simulation. Their simulation builds are unchanged (the same PT_LOAD bytes); only the fpga=1 builds
    differ. pmu_IOPMP_L2RW_test and pmu_aplic_test have the same code but do not build on this branch (their IOPMP / APLIC
    driver functions are missing), so they are left as they are.
2026-10-31 docs/cores.md: a four-core bitstream's memory-port sources from 4 up changed with the Ethernet DMA's own port
    The paragraph said a four-core bitstream keeps the source codes it had, so four-core software runs on it unchanged.
    That holds for the register layout, the ports and the cores' codes 0-3, not for the memory-port sources from 4 up:
    since bcb88607, 4 is the accelerator socket's DMA alone, 5 the Ethernet DMA, and the other crossbar masters moved up
    by one (hardware/ip_list/apmu/README.md already says so).
2026-10-31 soc_tests/t_spulat: the SPUs' write latency and the socket SPU's latency (no test had measured either)
    Core 0 stores to 32 lines and loads 16 outside the LLC window, then fence.i: exactly 48 reads and 32 write-backs
    of source 0 on the memory port's SPU (APMU port 2N+1), with their latency sums (ADD_RESP_LAT) and the smallest and
    largest single latency (the KEEP_MIN / KEEP_MAX opcodes, used here for the first time). Then the accelerator
    socket's example engine copies 24 words: exactly 24 of each event on the socket's SPU (port 2N+2) and on port
    2N+1's source N. Each latency is checked against a floor of 22 cycles (the slowdown's earliest release and its
    20-cycle R/B delay) and an upper margin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
2026-10-31 soc_tests/t_sweep_probe, dram_model.md: why t_sweep's 1 GHz curve hardly moves on OpenDRAM 16x (settled on the board)
    On the 10-30 bitstreams t_sweep's 1 GHz curve lay only about 1 cycle per read above the model-off one although the
    model held reads back 17 cycles on average, and at 1152 and 1280 KB it lay below it; dram_model.md left both open.
    t_sweep_probe (print-only apart from checking that the model is present; it includes t_sweep.c unchanged) settles
    both on the VCU118, 2026-10-31, with the 8-core and the 4-core 10-30 bitstream (they agree to within 0.07 cycles
    per read):
    - The hold counters judge a refill's first beat, but the LLC answers only when all 8 beats are in. At 2 MB, LAT_RD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
2026-10-31 axi_dram_timing, dram_model.md: exact late-beat rule; the time base's 4-day wrap documented; 4-core probe agreement
    axi_dram_timing.sv, comments only (the one code line touched, TW = 48, lost its trailing comment):
    - The header gives the timing exactly: a read or write burst starts lat_rd / lat_wr after its AR / AW but not
    before the modelled bus is free, then holds the bus for its bus time; the first read beat is modelled at the
    burst's start, the others occ16 / 16 cycles apart, the write response at max(AW + lat_wr, bus free) + bus time.
    - "the beat is released at arrival" is replaced by what the RTL does: while enabled every beat spends at least a
    cycle in its buffer, so a beat is d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
2026-10-31 c1_v2, pmu_evu_c1_track: inter-core flags in .sbss/.bss, not the APMU's DSPM; bounded waits, honest last lines
    On the VCU118 (2026-10-31, 4-core 10-30 bitstream) c1_v2 counted 0 of 5 hits on all four PC milestones: DONE
    already read 1 when Core 0 gave the start signal, every counter was 0, and the bench still printed "All 4 PC
    milestones tracked". The unchanged bench in xsim (4 cores, clean DSPM) counted 5 per probe, so the EVU and the
    APMU count repeated PC-milestone hits; the bench's flags were the problem. START (DSPM + 0x10) and DONE (+ 0x20)
    sat in the APMU's DSPM and were never cleared, and the DSPM keeps its contents from one program to the next (the
    APMU's processing element uses it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
2026-11-01 cva6_subsystem: reset the debug module's bus bridge with ndmreset, as the crossbar that feeds it
    i_dm_axi2mem (the axi2mem in front of the debug module's memory) was on the power-on reset
    (rst_ni), the crossbar feeding it on ndmreset_n. A single-beat write reaches the bridge with
    its W one cycle after its AW (axi_mux forwards W from a non-fall-through FIFO: FallThrough 0,
    CUT_ALL_PORTS), so every HALTED store of a hart parked in the debug ROM spends a cycle in
    WAIT_WVALID. An ndmreset in that cycle (OpenOCD's reset halt with the harts halted) cleared
    the W inside the crossbar but not the bridge, which then waited for it for ever with
    aw_ready = ar_ready = 0: no hart could fetch the debug ROM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
2026-11-04 dram_model.md: every SoC reset clears the model's time base, and a wrap stall lasts until a reset
    The wrap paragraph said only programming the FPGA resets the time base and that the memory path stops for up to four
    more days. On the FPGA, alsaqr_clk_rst_gen.sv ANDs the debug module's ndmreset into the SoC reset, so the board's
    reset button and OpenOCD's `reset halt` also clear the time base and the enable bit (apb_soc_control is on the same
    reset). A held response comes out at most 2^44 cycles later, but with the model still on the next ones are held
    again, and a release time in the last cycle before the wrap (OCC16 not a multiple of 16, e.g. the 1 GHz value 20) is
    never reached, so in pract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
2026-11-04 cva6/evu: Added PID filtering support. EVUs transmit context IDs to the APMU
    - csr_regfile: added the scontext (0x5A8) and mcontext (0x7A8) CSRs. hcontext (0x6A8) is an alias of mcontext.
    - cva6: added scontext/hcontext change detection. e_info carries the new context ID, s_id carries {v, priv_lvl}.
    - perf_counters_evu: added the SCONTEXT_CHANGE (0x18) and HCONTEXT_CHANGE (0x19) events. All events now have the same 2-cycle latency.
    - sw: added the bare-metal cva6_evu test.
    - inc/pmu: added shared pmu_defines.h and evu_defines.h headers.
    - encoding.h: added the scontext and hcontext CSR defines.
2026-11-08 soc_tests/t_iopmp: a test of the APMU's IOPMP, bare metal and under Linux
    Core 0 programs the IOPMP and has the APMU's processing element make EVU accesses through a mailbox in the DSPM,
    then checks each access and the IOPMP's error record: the reset state, off (everything passes), read/write,
    read-only and write-only entries, NAPOT and TOR entries, priority entries, domains, the interrupt (PLIC source 14),
    and an allow-everything entry, which it leaves so that APMU firmware run later without a reset still gets through.
    161 checks.
    linux/ builds the same t_iopmp.c as a Linux program. Its soc_test.h reaches the registers through /dev/mem, and for
    the interrupt check it sets hart 0's M-mode P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
2026-11-11 soc_tests/t_hpm_irq: the overflow interrupt of CVA6's six counters, on every hart
    t_hpm_irq checks local interrupt 13 (Sscofpmf) for mhpmcounter3..8 on every hart: each counter
    alone and all six together (their bits in scountovf), a counter wrapping on exactly the K-th event
    of a fixed code region for the events counted at retirement, the other events on a workload that
    makes many of them, sampling of user code, delegation to S-mode, the enables (mie.LCOFIE,
    mcountinhibit, MINH), and all harts at the same time.
    Passes on the VCU118 with alsaqr_main_8core_20261107.bit (152 checks) and
    alsaqr_main_4core_20261107.bit (124 checks), as do t_hpm and t_sscofpmf. hardware/docs/hpm.md
    gains a sectio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
2026-11-13 apmu/ibex: illegal counter encodings no longer send a counter request
    The decoder sets counter_req_o for every opcode-0x07 instruction, and the
    illegal-instruction block cleared data_req_o and the other request signals
    but not counter_req_o. This Ibex has no writeback stage, so an illegal
    instruction still executes in ID: an illegal counter encoding (funct3 1xx,
    or funct3 000/010 with an unknown funct7) moved the ID-stage FSM to
    MULTI_CYCLE before the trap, and the flush left it there. The first
    instruction of the trap handler then ran as a second cycle: a jump did not
    jump, and a load, store or counter instruction never sent its request and
    hung. Clear counter_req_o with the other request s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
