Rodolfo-Pellizzoni-Lab/he-soc/(notices)

Notices in the files:
hardware/ip_list/axi_llc/README.md:
License: SHL-0.51
